nativosistemas/piezas3D/specs/009-espacio-conectores/checklists/requirements.md

# Lista de calidad de la especificación: Espacio para conectores y cableado

**Propósito**: validar que la especificación esté completa y sea de calidad antes de planificar
**Creada**: 2026-10-15
**Funcionalidad**: [spec.md](../spec.md)

## Calidad del contenido

- [x] Sin detalles de implementación (lenguajes, frameworks, APIs)
- [x] Centrada en el valor para el usuario y en las necesidades
- [x] Escrita para personas no técnicas
- [x] Todas las secciones obligatorias completas

## Completitud de los requisitos

- [x] No quedan marcadores [NEEDS CLARIFICATION]
- [x] Los requisitos se pueden probar y no son ambiguos
- [x] Los criterios de éxito son medibles
- [x] Los criterios de éxito no dependen de la tecnología
- [x] Todos los escenarios de aceptación están definidos
- [x] Los casos límite están identificados
- [x] El alcance está delimitado
- [x] Las dependencias y los supuestos están identificados

## Preparación de la funcionalidad

- [x] Todos los requisitos funcionales tienen criterios de aceptación claros
- [x] Los escenarios de usuario cubren los flujos principales
- [x] La funcionalidad cumple los resultados medibles de los criterios de éxito
- [x] No se filtran detalles de implementación en la especificación

## Notas

- Las menciones al ensamblaje, la tapa, la plataforma y los STL nombran artefactos del propio
  proyecto (como en 002 y 006), no tecnologías.
- El tipo de conector (rectos) se tomó como supuesto: es lo que figura en la lista de materiales y
  queda parametrizado.
