nativosistemas/piezas3D/specs/002-puntero-laser-estelar/checklists/requirements.md

# Lista de calidad de la especificación: Puntero láser estelar motorizado (alt-az)

**Propósito**: Validar que la especificación esté completa y sea de calidad antes de planificar
**Creada**: 2026-10-04
**Funcionalidad**: [spec.md](../spec.md)

## Calidad del contenido

- [x] Sin detalles de implementación (lenguajes, frameworks, APIs)
- [x] Centrada en el valor para el usuario y en sus necesidades
- [x] Redactada para personas sin conocimientos técnicos
- [x] Todas las secciones obligatorias completas

## Completitud de los requisitos

- [x] No quedan marcadores [NEEDS CLARIFICATION]
- [x] Los requisitos se pueden probar y no son ambiguos
- [x] Los criterios de éxito son medibles
- [x] Los criterios de éxito no dependen de la tecnología (sin detalles de implementación)
- [x] Todos los escenarios de aceptación están definidos
- [x] Los casos límite están identificados
- [x] El alcance está bien delimitado
- [x] Las dependencias y los supuestos están identificados

## Preparación de la funcionalidad

- [x] Todos los requisitos funcionales tienen criterios de aceptación claros
- [x] Los escenarios de usuario cubren los flujos principales
- [x] La funcionalidad cumple los resultados medibles de los criterios de éxito
- [x] No se filtran detalles de implementación en la especificación

## Notas

- Validación aprobada en la primera pasada.
- Los componentes comprados (28BYJ-48, ULN2003, ESP32, relé, láser 303, correa GT2, rodamientos
  608ZZ, rosca 3/8"-16) son **restricciones del usuario**, no decisiones de implementación. Por eso
  se nombran en la especificación. No se mencionan herramientas de software (OpenSCAD, FreeCAD) ni
  la forma de los archivos.
- Las medidas por defecto del láser, el power bank, el ESP32 y el relé son supuestos que hay que
  verificar midiendo los componentes reales antes de imprimir. Se pueden fijar en `/speckit-clarify`
  o en la planificación.
- El firmware del ESP32 queda fuera de alcance. Solo se documentan sus requisitos (FR-026).
