nativosistemas/piezas3D/specs/013-circuito-laser/checklists/requirements.md

# Lista de control de calidad de la especificación: Circuito del láser en el visor 3D

**Propósito**: Validar que la especificación esté completa y sea de calidad antes de planificar
**Creada**: 2026-10-19
**Funcionalidad**: [spec.md](../spec.md)

## Calidad del contenido

- [x] Sin detalles de implementación (lenguajes, bibliotecas, APIs)
- [x] Centrada en el valor para el usuario y en la necesidad
- [x] Escrita para personas no técnicas
- [x] Todas las secciones obligatorias completas

## Completitud de los requisitos

- [x] No quedan marcadores [NEEDS CLARIFICATION]
- [x] Los requisitos se pueden probar y no son ambiguos
- [x] Los criterios de éxito son medibles
- [x] Los criterios de éxito no dependen de la tecnología
- [x] Todos los escenarios de aceptación están definidos
- [x] Los casos límite están identificados
- [x] El alcance está bien delimitado
- [x] Las dependencias y los supuestos están identificados

## Preparación de la funcionalidad

- [x] Cada requisito funcional tiene criterios de aceptación claros
- [x] Los escenarios de usuario cubren los flujos principales
- [x] La funcionalidad cumple los resultados medibles de los criterios de éxito
- [x] No se filtran detalles de implementación en la especificación

## Notas

- La especificación nombra archivos del repositorio (ensamblaje, lista de materiales) y el paso 14
  porque son el objeto del pedido, como en las features 008 y 011; no fija cómo implementarlo.
- Decisiones tomadas sin preguntar (en Supuestos): el circuito empieza en la salida del regulador,
  las piezas metálicas se modelan simplificadas y el tubo del láser representa el retorno.
