nativosistemas/piezas3D/specs/012-marcas-orientacion/checklists/requirements.md

# Checklist de calidad de la especificación: Marcas de orientación y de altura del puntero láser

**Propósito**: validar que la especificación esté completa y sea de calidad antes de planificar
**Creada**: 2026-10-17
**Funcionalidad**: [spec.md](../spec.md)

## Calidad del contenido

- [x] Sin detalles de implementación (lenguajes, frameworks, APIs)
- [x] Centrada en el valor para el usuario y en sus necesidades
- [x] Redactada para personas no técnicas
- [x] Todas las secciones obligatorias completas

## Completitud de los requisitos

- [x] No quedan marcadores [NEEDS CLARIFICATION]
- [x] Los requisitos se pueden probar y no son ambiguos
- [x] Los criterios de éxito son medibles
- [x] Los criterios de éxito no dependen de la tecnología
- [x] Todos los escenarios de aceptación están definidos
- [x] Los casos límite están identificados
- [x] El alcance está bien delimitado
- [x] Las dependencias y los supuestos están identificados

## Preparación de la funcionalidad

- [x] Todos los requisitos funcionales tienen criterios de aceptación claros
- [x] Los escenarios de usuario cubren los flujos principales
- [x] La funcionalidad cumple los resultados medibles de los criterios de éxito
- [x] No se filtran detalles de implementación en la especificación

## Notas

- Las piezas se nombran (base fija, plataforma, polea de altura, brazo del motor) porque son el objeto
  del pedido, no un detalle de implementación. La forma, el tamaño y la ubicación exacta de cada marca
  quedan para el plan.
- El usuario descartó el nivel de burbuja y eligió la escala de altura cada 15°.
- El signo y el valor de la declinación magnética no se fijan en la spec: se verifican con una fuente
  oficial al escribir la guía.
