nativosistemas/piezas3D/specs/010-barra-distribucion/checklists/requirements.md

# Lista de control de calidad de la especificación: Barra de distribución de alimentación

**Propósito**: Validar que la especificación esté completa y sea de calidad antes de planificar
**Creada**: 2026-10-17
**Funcionalidad**: [spec.md](../spec.md)

## Calidad del contenido

- [x] Sin detalles de implementación (lenguajes, archivos, módulos)
- [x] Centrada en el valor para quien arma el aparato
- [x] Redactada para personas no especialistas en el código
- [x] Todas las secciones obligatorias completas

## Completitud de los requisitos

- [x] No quedan marcas [NEEDS CLARIFICATION]
- [x] Los requisitos se pueden probar y no son ambiguos
- [x] Los criterios de éxito son medibles
- [x] Los criterios de éxito no dependen de la tecnología
- [x] Todos los escenarios de aceptación están definidos
- [x] Los casos límite están identificados
- [x] El alcance está acotado
- [x] Las dependencias y los supuestos están identificados

## Preparación de la funcionalidad

- [x] Cada requisito funcional tiene criterios de aceptación claros
- [x] Los escenarios de usuario cubren los flujos principales
- [x] La funcionalidad cumple los resultados medibles de los criterios de éxito
- [x] No se filtran detalles de implementación en la especificación

## Notas

- Términos como Dupont, placa perforada, multímetro o comprobaciones de choque son del dominio
  (componentes y validación del diseño), no de la implementación; se usan igual que en la 009.
- Las medidas por defecto de la placa y la asignación de pines se confirman en `/speckit-plan`.
