nativosistemas/piezas3D/specs/004-caja-pilas-aa/checklists/requirements.md

# Lista de calidad de la especificación: Caja con tapa a presión para 4 pilas AA

**Propósito**: Validar que la especificación esté completa antes de planificar
**Creada**: 2026-10-06
**Funcionalidad**: [spec.md](../spec.md)

## Calidad del contenido

- [x] Sin detalles de implementación (lenguajes, frameworks, APIs)
- [x] Centrada en el valor para el usuario
- [x] Redactada para personas no técnicas
- [x] Todas las secciones obligatorias completas

## Completitud de los requisitos

- [x] No quedan marcadores [NEEDS CLARIFICATION]
- [x] Los requisitos se pueden probar y no son ambiguos
- [x] Los criterios de éxito son medibles
- [x] Los criterios de éxito no dependen de la tecnología
- [x] Todos los escenarios de aceptación están definidos
- [x] Los casos límite están identificados
- [x] El alcance está acotado
- [x] Dependencias y supuestos identificados

## Preparación de la funcionalidad

- [x] Todos los requisitos funcionales tienen criterios de aceptación claros
- [x] Los escenarios cubren los flujos principales
- [x] La funcionalidad cumple los resultados medibles de los criterios de éxito
- [x] No se filtran detalles de implementación en la especificación

## Notas

- Las herramientas (OpenSCAD, perfil de impresora) solo se nombran en los supuestos y en FR-009,
  porque las fija la constitución del proyecto, igual que en las especificaciones 001 y 002.
