nativosistemas/piezas3D/specs/005-visor-armado-3d/checklists/requirements.md

# Specification Quality Checklist: Visor 3D de armado paso a paso

**Purpose**: Validate specification completeness and quality before proceeding to planning
**Created**: 2026-10-08
**Feature**: [spec.md](../spec.md)

## Content Quality

- [x] No implementation details (languages, frameworks, APIs)
- [x] Focused on user value and business needs
- [x] Written for non-technical stakeholders
- [x] All mandatory sections completed

## Requirement Completeness

- [x] No [NEEDS CLARIFICATION] markers remain
- [x] Requirements are testable and unambiguous
- [x] Success criteria are measurable
- [x] Success criteria are technology-agnostic (no implementation details)
- [x] All acceptance scenarios are defined
- [x] Edge cases are identified
- [x] Scope is clearly bounded
- [x] Dependencies and assumptions identified

## Feature Readiness

- [x] All functional requirements have clear acceptance criteria
- [x] User scenarios cover primary flows
- [x] Feature meets measurable outcomes defined in Success Criteria
- [x] No implementation details leak into specification

## Notes

- Las 3 aclaraciones se resolvieron el 2026-10-08 (sección "Aclaraciones" de la especificación):
  visor en página aparte, realidad aumentada fuera del alcance y visor obligatorio (enmienda de la
  constitución).
- Las menciones a three.js, OpenSCAD y `generar_web.py` aparecen solo en la cita textual de la
  entrada del usuario; los requisitos no dependen de ellas.
