nativosistemas/piezas3D/specs/001-soporte-pared-taladro/checklists/requirements.md

# Lista de verificación de calidad de la especificación: Soporte de pared paramétrico para taladro

**Propósito**: Validar que la especificación está completa y tiene calidad suficiente antes de pasar a la planificación
**Creada**: 2026-10-04
**Funcionalidad**: [spec.md](../spec.md)

## Calidad del contenido

- [x] Sin detalles de implementación (lenguajes, frameworks, APIs)
- [x] Centrada en el valor para el usuario y en las necesidades del negocio
- [x] Redactada para personas no técnicas
- [x] Todas las secciones obligatorias completadas

## Completitud de los requisitos

- [x] No quedan marcadores [NEEDS CLARIFICATION]
- [x] Los requisitos son verificables y no ambiguos
- [x] Los criterios de éxito son medibles
- [x] Los criterios de éxito no dependen de la tecnología (sin detalles de implementación)
- [x] Todos los escenarios de aceptación están definidos
- [x] Los casos límite están identificados
- [x] El alcance está claramente delimitado
- [x] Las dependencias y los supuestos están identificados

## Preparación de la funcionalidad

- [x] Todos los requisitos funcionales tienen criterios de aceptación claros
- [x] Los escenarios de usuario cubren los flujos principales
- [x] La funcionalidad cumple los resultados medibles definidos en los criterios de éxito
- [x] No se filtran detalles de implementación en la especificación

## Notas

- Validación superada en la primera iteración (2026-10-04).
- La especificación no nombra herramientas de modelado ni de simulación; menciona conceptos de
  manufactura (FDM, perímetros, boquilla de 0,4 mm) porque forman parte del dominio del producto
  (una pieza impresa) y no de su implementación. Las herramientas las fija la constitución.
- No se usaron marcadores [NEEDS CLARIFICATION]: el tipo de taladro, el modo de sujeción (colgado
  por el portabrocas en ranura en U), la carga de diseño (2,5 kg, factor de seguridad 3) y el material
  (PETG) se resolvieron como supuestos documentados. Si alguno no coincide con la intención del
  usuario, conviene ajustarlo con `/speckit-clarify` antes de `/speckit-plan`.
- La validación estructural (FR-014/FR-015) se considera aplicable porque la pieza trabaja en
  voladizo bajo carga permanente (Principio III de la constitución).
