nativosistemas/piezas3D/specs/001-soporte-pared-taladro/spec.md

# Especificación de Funcionalidad: Soporte de pared paramétrico para taladro

**Rama de la funcionalidad**: N/A (sin hook de creación de rama; se trabaja sobre `main`)

**Creada**: 2026-10-04

**Estado**: Implementada (pendiente de la prueba física)

**Entrada**: Descripción del usuario: "Soporte de pared paramétrico para un taladro, con ancho, profundidad y diámetro de tornillos ajustables"

## Escenarios de usuario y pruebas *(obligatorio)*

### Historia de usuario 1 - Fabricar e instalar el soporte con valores por defecto (Prioridad: P1)

Una persona aficionada al bricolaje quiere guardar su taladro atornillador inalámbrico colgado en la
pared del taller. Toma el diseño con sus valores por defecto, imprime la pieza en una impresora 3D
doméstica de filamento, la atornilla a la pared siguiendo la guía de producción y cuelga el taladro
con la punta (portabrocas) hacia abajo, pasando el portabrocas por la ranura frontal del soporte de
modo que el cuerpo del taladro descanse sobre la bandeja.

**Por qué esta prioridad**: es el valor central de la funcionalidad: una pieza física, lista para
imprimir y montar, que sostiene un taladro estándar de forma segura sin que el usuario tenga que
modificar nada.

**Prueba independiente**: se imprime la pieza por defecto, se fija a una pared con la tornillería
indicada en la guía y se cuelga un taladro inalámbrico típico con batería; el taladro queda estable,
se puede sacar y volver a colocar con una mano y la pieza no presenta grietas ni deformación visible.

**Escenarios de aceptación**:

1. **Dado** el diseño con sus valores por defecto, **cuando** se prepara para imprimir, **entonces**
   la pieza se imprime en una sola pieza, sin material de soporte, en una cama de impresión de
   180 × 180 mm o mayor.
2. **Dado** el soporte impreso y fijado a la pared con 2 tornillos del diámetro por defecto,
   **cuando** se cuelga un taladro inalámbrico de hasta 2,5 kg (con batería), **entonces** el taladro
   queda retenido por el portabrocas en la ranura, sin caerse ni balancearse hasta salirse.
3. **Dado** el taladro colgado, **cuando** el usuario lo retira y lo vuelve a colocar con una sola
   mano, **entonces** la operación no requiere forzar la pieza ni herramientas.
4. **Dado** el diseño entregado, **cuando** el usuario consulta la guía de producción, **entonces**
   encuentra la orientación de impresión, los parámetros del laminador, el material recomendado, la
   lista de tornillería y los pasos de instalación en pared.

---

### Historia de usuario 2 - Adaptar el soporte a un taladro y una tornillería concretos (Prioridad: P2)

El usuario tiene un taladro más grande (o más pequeño) que el de referencia, o dispone de tornillos de
otro diámetro. Ajusta los parámetros de ancho, profundidad y diámetro de tornillo (y, si lo necesita,
el ancho de la ranura del portabrocas) en la sección de parámetros del diseño y obtiene una nueva pieza
coherente con esos valores, sin tener que modificar la geometría.

**Por qué esta prioridad**: la parametrización es lo que convierte la pieza en un generador
reutilizable; sin ella solo serviría para un taladro concreto.

**Prueba independiente**: se cambian el ancho, la profundidad y el diámetro de tornillo a valores
dentro de los rangos admitidos, se regenera la pieza y se miden en el modelo resultante las cotas
afectadas; coinciden con los valores introducidos (dentro de la tolerancia declarada).

**Escenarios de aceptación**:

1. **Dado** el diseño, **cuando** el usuario cambia el ancho a 100 mm, **entonces** la pieza generada
   mide 100 mm de ancho y la ranura sigue centrada.
2. **Dado** el diseño, **cuando** el usuario cambia la profundidad a 130 mm, **entonces** la bandeja
   sobresale 130 mm de la pared y los refuerzos laterales se escalan en proporción.
3. **Dado** el diseño, **cuando** el usuario cambia el diámetro de tornillo de 5 mm a 4 mm,
   **entonces** los orificios de fijación y sus avellanados se recalculan para ese tornillo, con la
   holgura de paso declarada.
4. **Dado** el diseño, **cuando** el usuario introduce una combinación imposible (p. ej., una ranura
   más ancha que el ancho disponible), **entonces** la generación se detiene con un mensaje que indica
   qué parámetro está fuera de rango y cuál es el límite.

---
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
