nativosistemas/piezas3D/specs/012-marcas-orientacion/tasks.md

---

description: "Lista de tareas de las marcas de orientación y de altura del puntero láser"
---

# Tareas: Marcas de orientación y de altura del puntero láser

**Entrada**: documentos de diseño de `specs/012-marcas-orientacion/`

**Requisitos previos**: [plan.md](plan.md), [spec.md](spec.md), [research.md](research.md),
[data-model.md](data-model.md), [contracts/](contracts/), [quickstart.md](quickstart.md)

**Pruebas**: no hay tareas de prueba aparte. Cada fase se cierra con las validaciones de OpenSCAD
(M-01 a M-09), los casos que fallan a propósito, las capturas y los escenarios del quickstart.

**Organización**: por las cinco fases del pipeline (Principio II, como en la 009 a la 011). Cada tarea
lleva su historia de usuario:
- **US1**: orientar el aparato al sur y al oeste (P1).
- **US2**: reconocer el láser horizontal y leer su altura (P1).
- **US3**: arrancar desde una posición conocida (P2).
- **US4**: ver las marcas en la web y en el visor 3D (P3).
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
