nativosistemas/piezas3D/docs/img/caja_pilas_paso_01.png

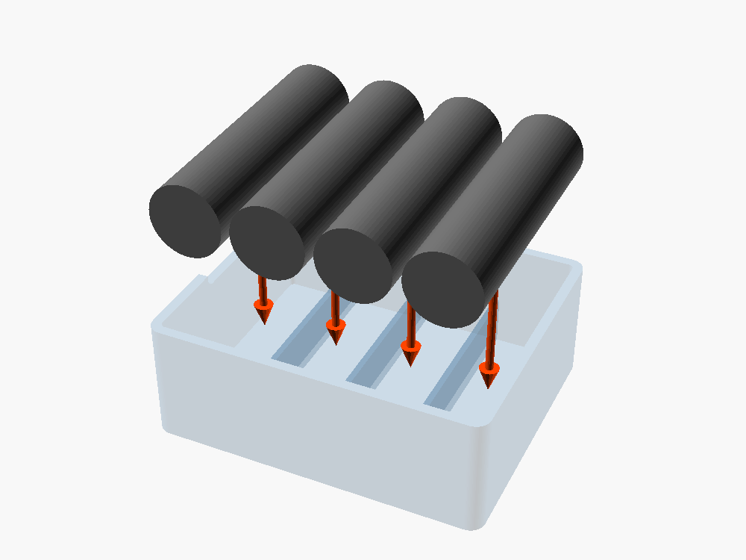
docs/img/caja_pilas_paso_01.png
