nativosistemas/piezas3D/docs/img/caja_pilas_paso_02.png

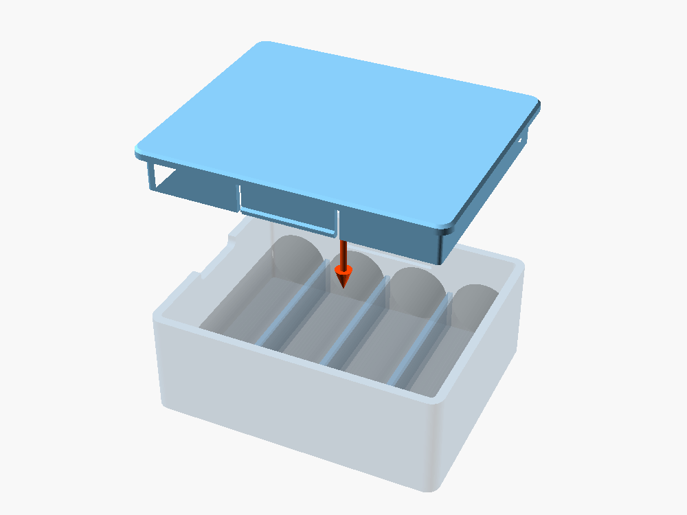
docs/img/caja_pilas_paso_02.png
