nativosistemas/piezas3D/docs/img/puntero_laser_paso_02.png

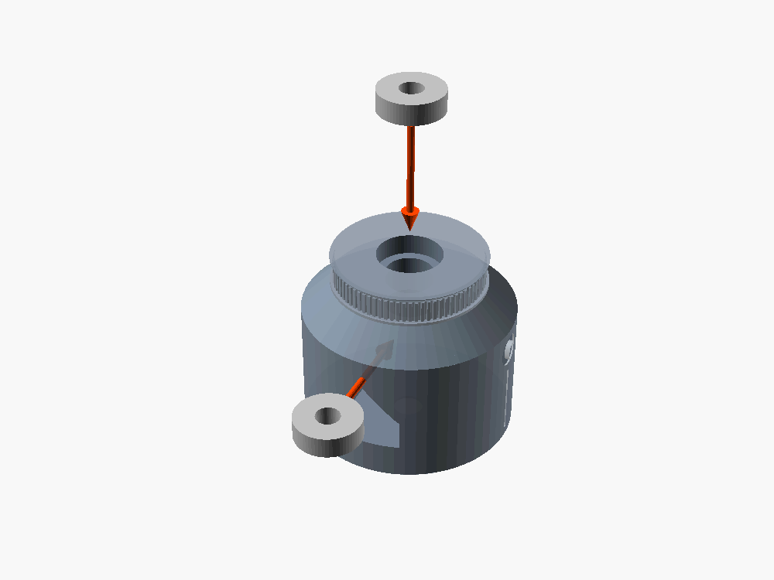
docs/img/puntero_laser_paso_02.png
