nativosistemas/piezas3D/docs/img/puntero_laser_paso_03.png

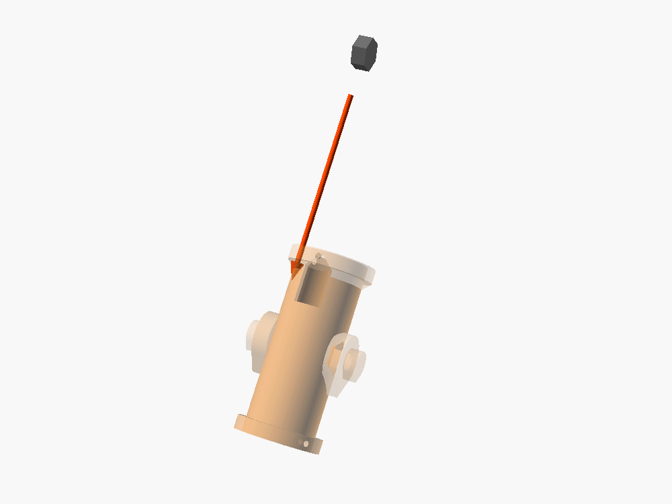
docs/img/puntero_laser_paso_03.png
