nativosistemas/piezas3D/docs/img/puntero_laser_paso_04.png

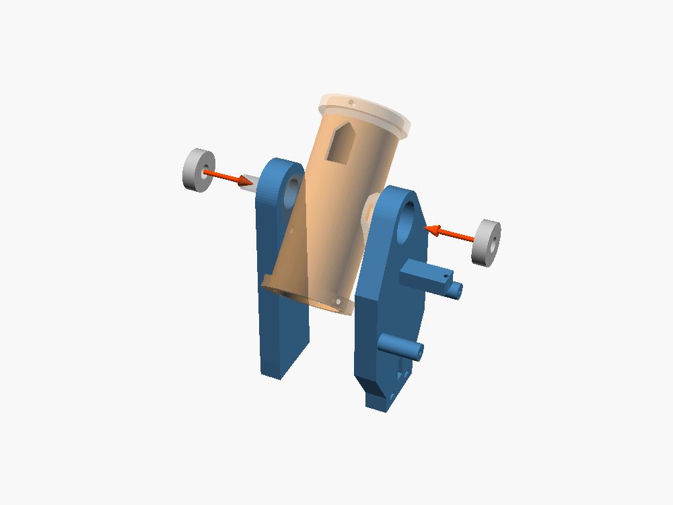
docs/img/puntero_laser_paso_04.png
