nativosistemas/piezas3D/docs/img/puntero_laser_paso_05.png

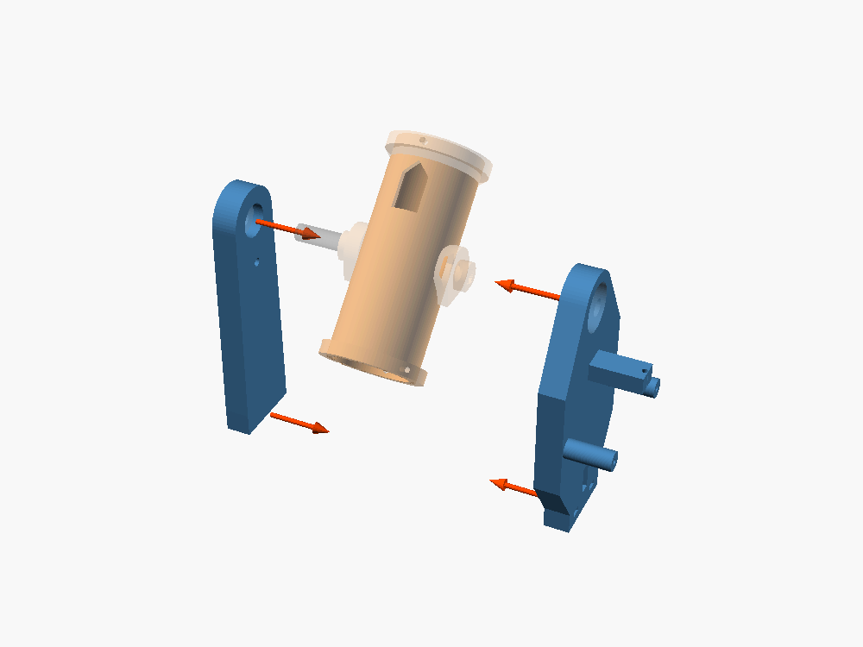
docs/img/puntero_laser_paso_05.png
