nativosistemas/piezas3D/docs/img/puntero_laser_paso_06.png

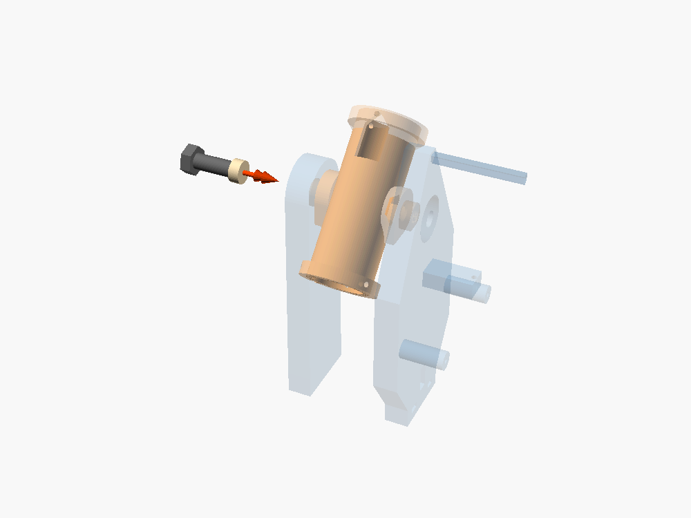
docs/img/puntero_laser_paso_06.png
