nativosistemas/piezas3D/docs/img/puntero_laser_paso_07.png

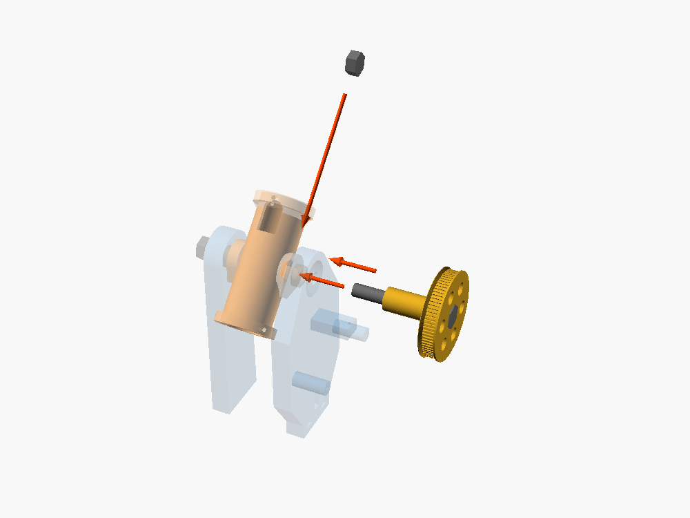
docs/img/puntero_laser_paso_07.png
