nativosistemas/piezas3D/docs/img/puntero_laser_paso_08.png

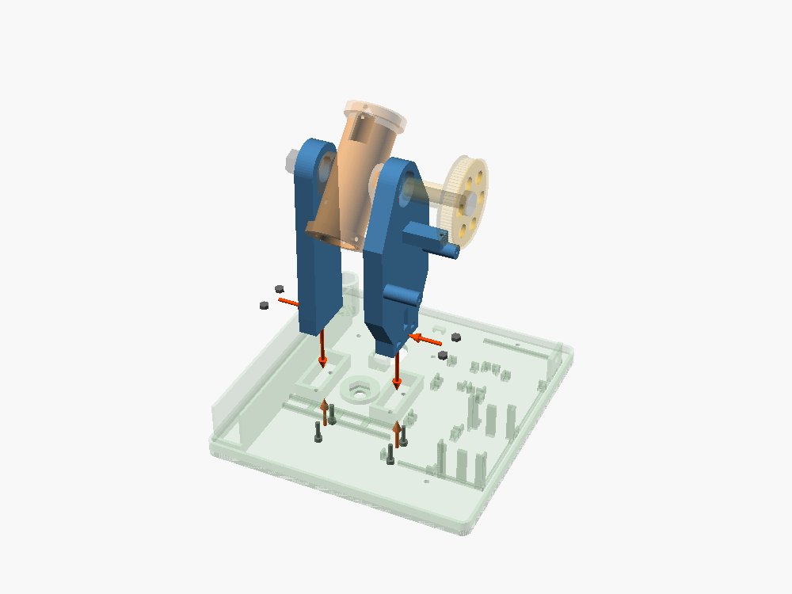
docs/img/puntero_laser_paso_08.png
