nativosistemas/piezas3D/docs/img/puntero_laser_paso_10.png

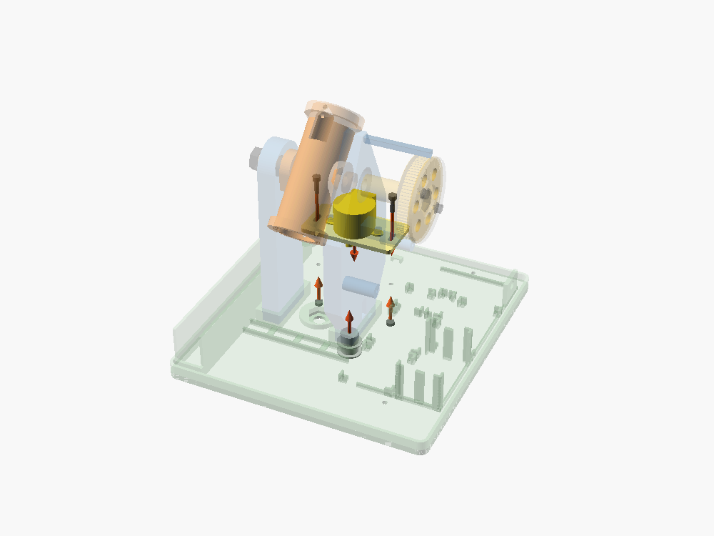
docs/img/puntero_laser_paso_10.png
