nativosistemas/piezas3D/docs/img/puntero_laser_paso_11.png

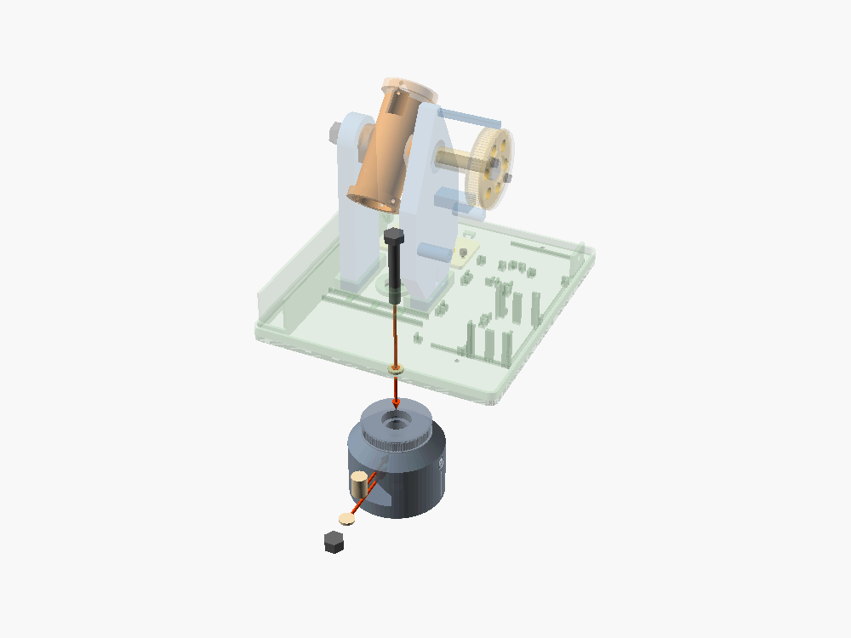
docs/img/puntero_laser_paso_11.png
