nativosistemas/piezas3D/docs/img/puntero_laser_paso_13.png

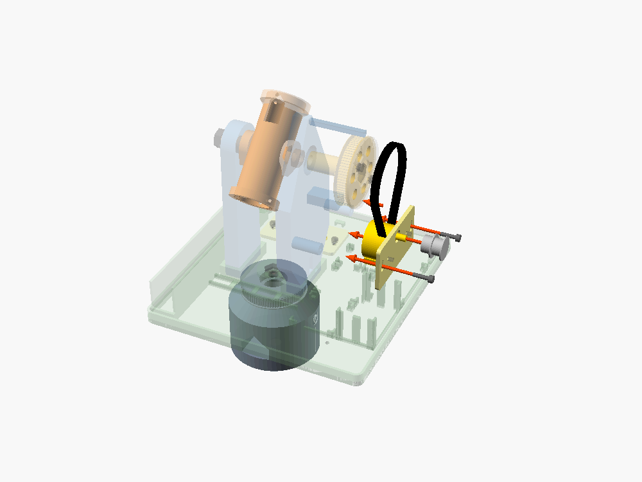
docs/img/puntero_laser_paso_13.png
