nativosistemas/piezas3D/docs/img/puntero_laser_paso_15.png

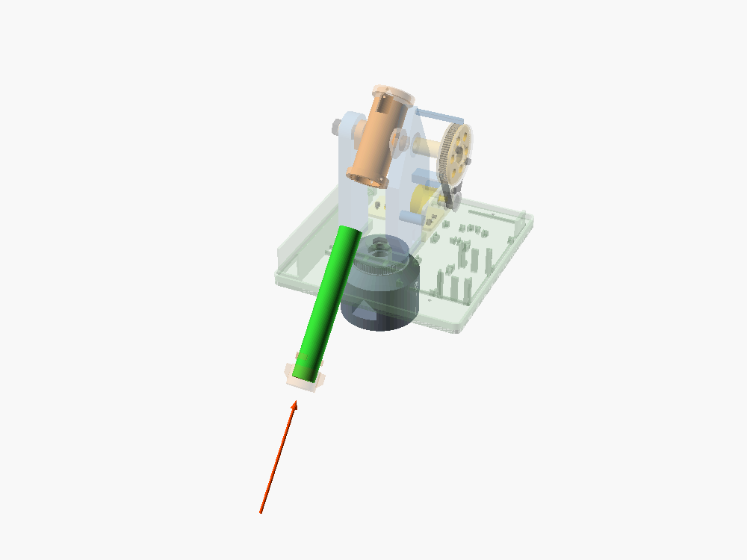
docs/img/puntero_laser_paso_15.png
