nativosistemas/piezas3D/docs/img/puntero_laser_paso_16.png

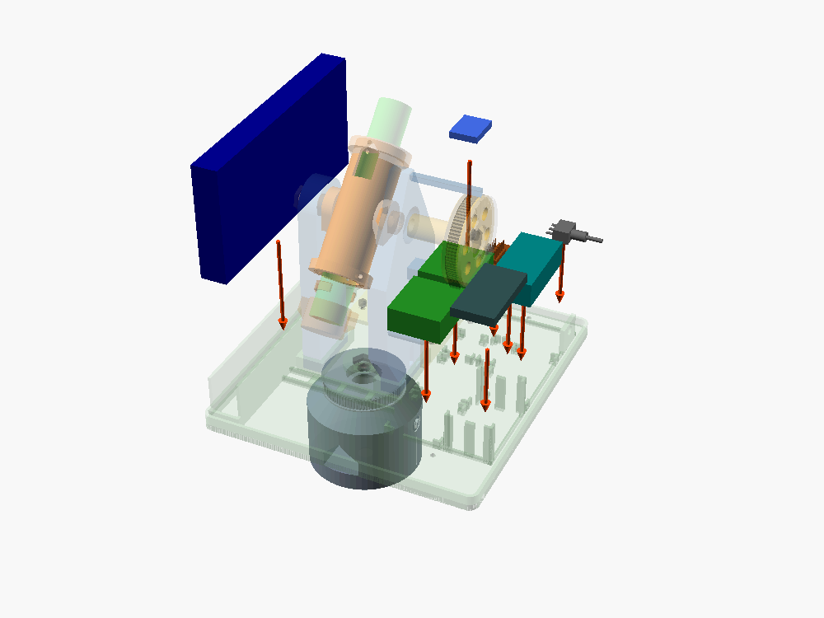
docs/img/puntero_laser_paso_16.png
