nativosistemas/piezas3D/docs/img/puntero_laser_paso_17.png

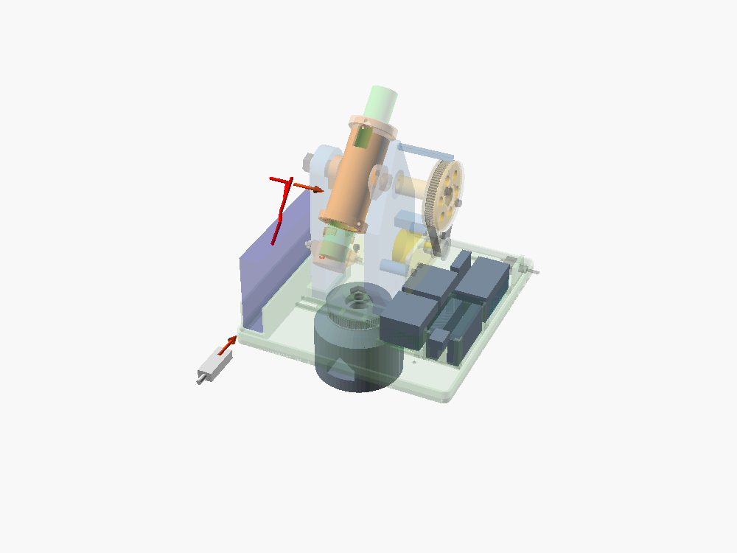
docs/img/puntero_laser_paso_17.png
