nativosistemas/piezas3D/docs/caja_pilas_bom.csv

categoria | texto_cantidad | descripcion | cantidad | unidad | paquete | opcional | en_guia | tengo | precio | moneda | tienda | url | fecha | nota
Filamento | 40 g de | filamento PETG de 1,75 mm (caja ≈ 25 g y tapa ≈ 12 g) | 40 | g | 1000 | no | si |  | 21100 | ARS | Printalot | https://printalot.com.ar/productos/filamentos/pet-g/petg-1-75-mm-1-kg/ | 2026-10-06 | Rollo de 1 kg. La página no confirma el stock. 40 g es la estimación por volumen de los STL: el laminador da el valor exacto
