nativosistemas/piezas3D/docs/tipo_cambio.csv

fecha | moneda | valor_ars | tipo | fuente | url
2026-10-05 | USD | 1540 | Dólar oficial (venta) | DolarApi | https://dolarapi.com/v1/dolares/oficial
