nativosistemas/piezas3D/exports/puntero_laser_disco_escala.stl

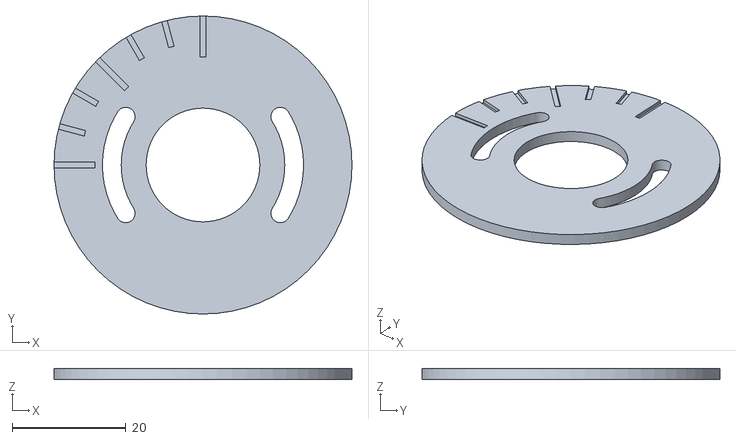
[picture p31: CAD file, 2026-10-17]
exports/puntero_laser_disco_escala.stl
52.4 x 52.4 x 2.00
