nativosistemas/piezas3D/simulation/soporte_pared_taladro.FCStd

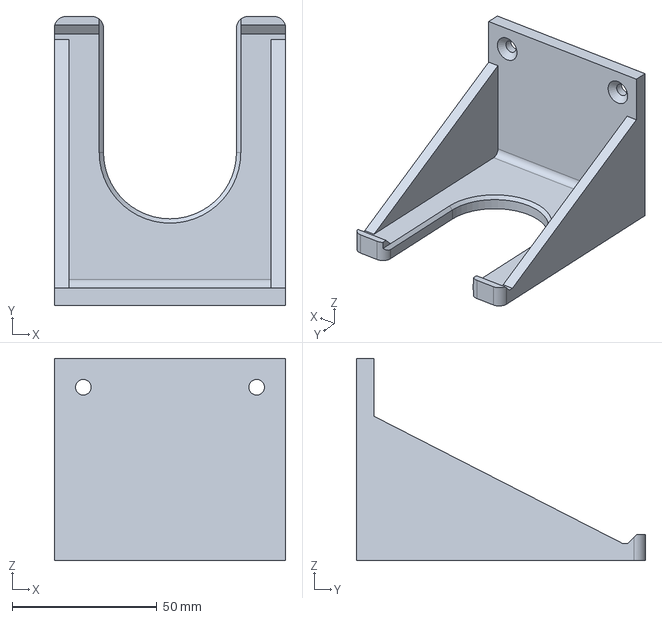
[picture p32: CAD file, 2026-10-04]
simulation/soporte_pared_taladro.FCStd
80.0 x 100.0 x 70.0 mm
