nativosistemas/piezas3D/exports/puntero_laser_adaptador_tripode.stl

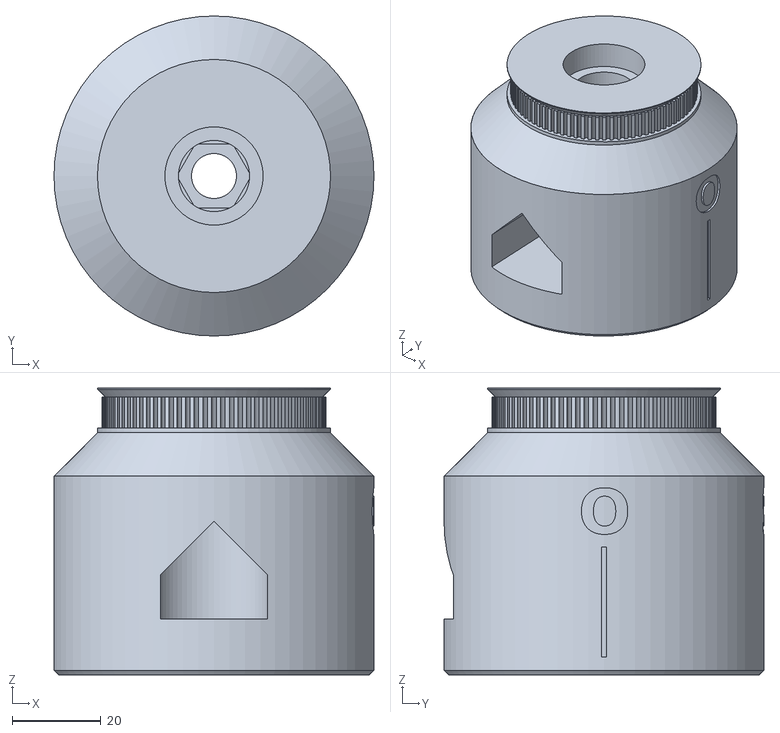
[picture p33: CAD file, 2026-10-17]
exports/puntero_laser_adaptador_tripode.stl
72.0 x 72.0 x 64.5
