nativosistemas/piezas3D/exports/puntero_laser_brazo_horquilla_motor.stl

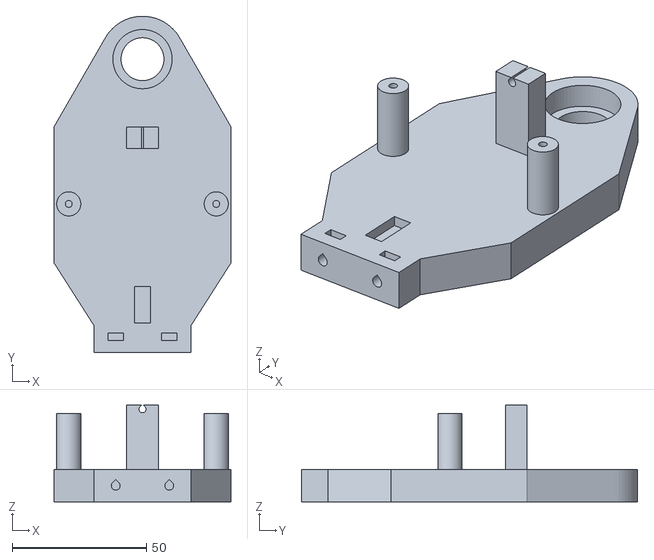
[picture p34: CAD file, 2026-10-17]
exports/puntero_laser_brazo_horquilla_motor.stl
66.0 x 125.5 x 36.0
