nativosistemas/piezas3D/exports/puntero_laser_grapa_cable.stl

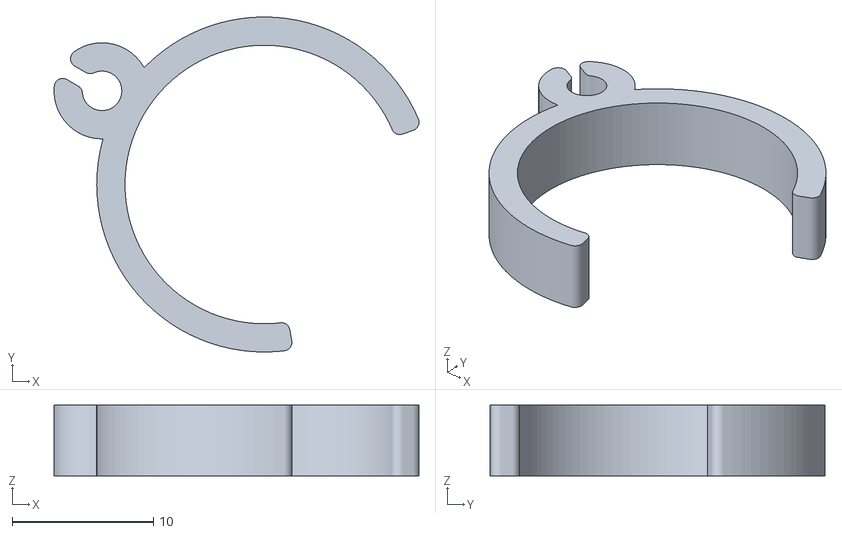
[picture p35: CAD file, 2026-10-17]
exports/puntero_laser_grapa_cable.stl
25.8 x 23.7 x 5.00
