nativosistemas/piezas3D/exports/puntero_laser_carro_motor.stl

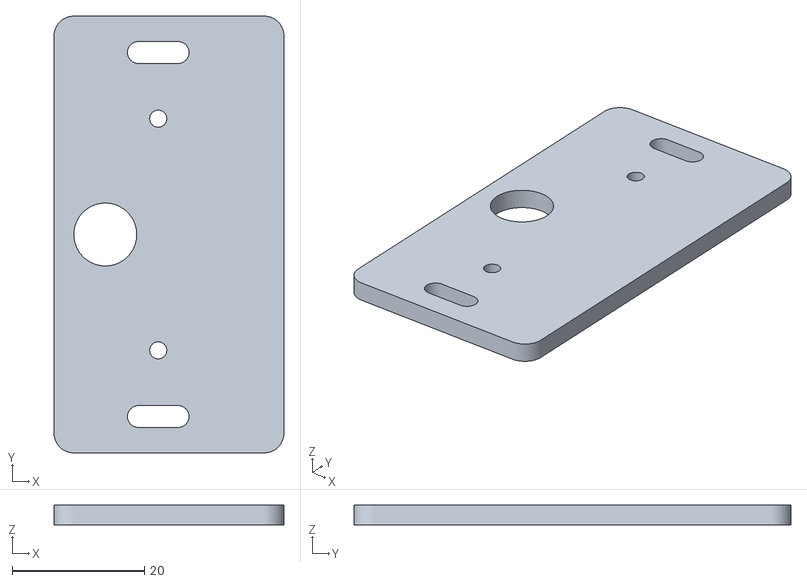
[picture p36: CAD file, 2026-10-17]
exports/puntero_laser_carro_motor.stl
34.8 x 66.0 x 3.00
