nativosistemas/piezas3D/exports/puntero_laser_pila_falsa.stl

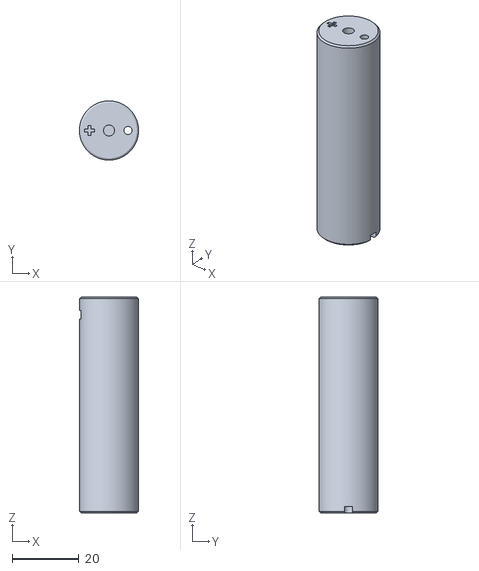
[picture p37: CAD file, 2026-10-15]
exports/puntero_laser_pila_falsa.stl
17.7 x 17.7 x 64.5
