nativosistemas/piezas3D/exports/puntero_laser_cuna_laser.stl

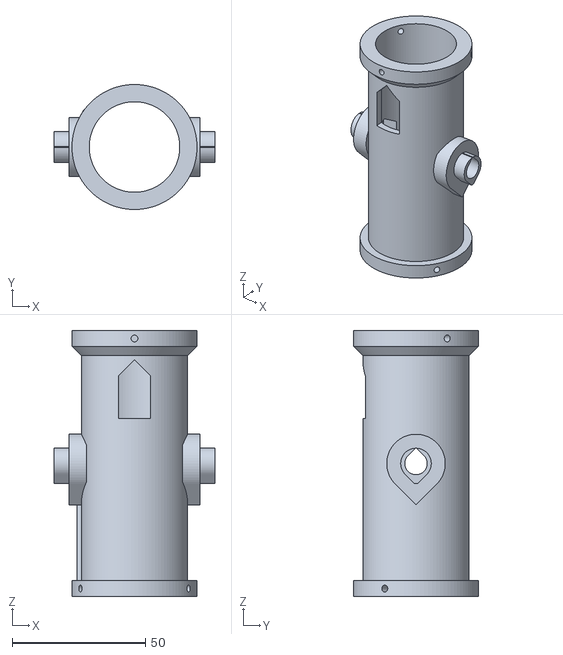
[picture p38: CAD file, 2026-10-15]
exports/puntero_laser_cuna_laser.stl
60.4 x 47.0 x 100.0
