nativosistemas/piezas3D/exports/puntero_laser_brazo_horquilla_cable.stl

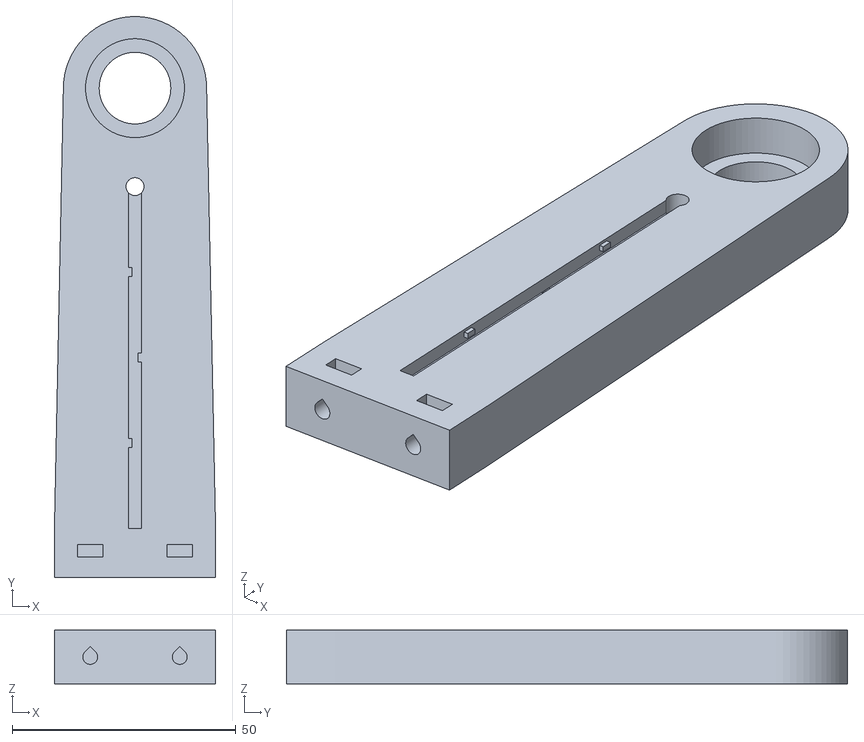
[picture p39: CAD file, 2026-10-15]
exports/puntero_laser_brazo_horquilla_cable.stl
36.0 x 125.3 x 12.0
