nativosistemas/piezas3D/exports/puntero_laser_tapa_electronica.stl

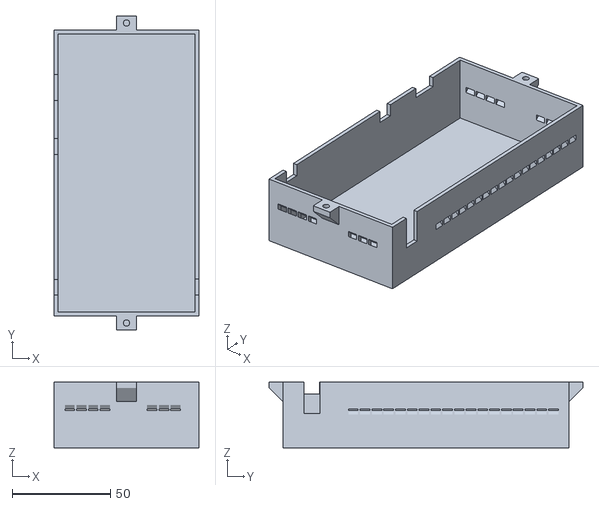
[picture p40: CAD file, 2026-10-15]
exports/puntero_laser_tapa_electronica.stl
73.9 x 159.9 x 33.5
