nativosistemas/piezas3D/exports/caja_pilas_tapa.stl

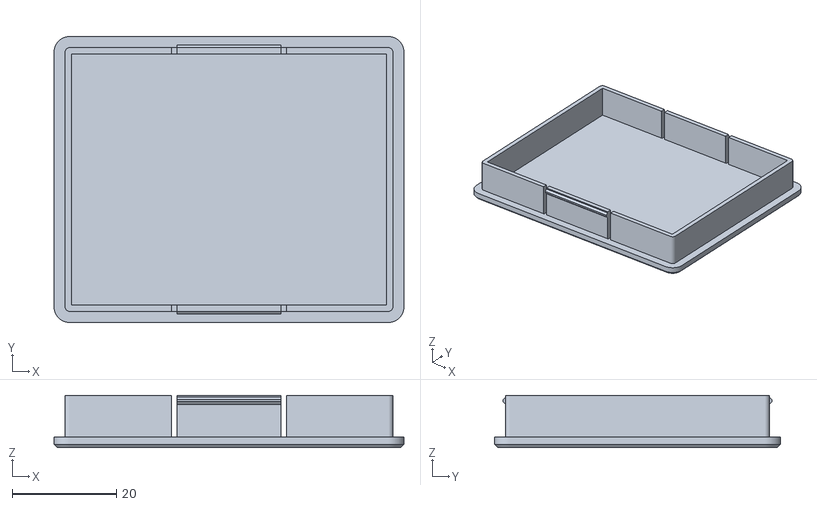
[picture p41: CAD file, 2026-10-08]
exports/caja_pilas_tapa.stl
67.2 x 54.9 x 10.0
