nativosistemas/piezas3D/exports/caja_pilas_caja.stl

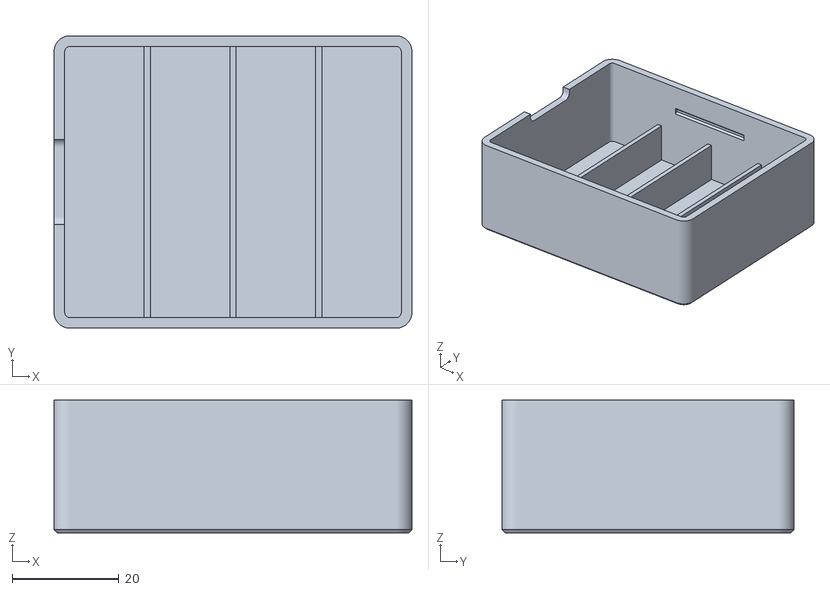
[picture p42: CAD file, 2026-10-08]
exports/caja_pilas_caja.stl
67.2 x 54.9 x 24.9
