nativosistemas/piezas3D/exports/puntero_laser_polea_altitud.stl

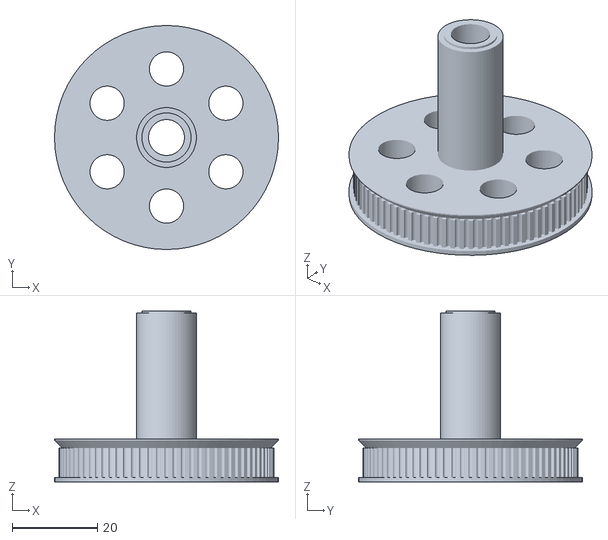
[picture p43: CAD file, 2026-10-08]
exports/puntero_laser_polea_altitud.stl
52.4 x 52.4 x 40.0
