nativosistemas/piezas3D/exports/puntero_laser_probeta_ajuste_608.stl

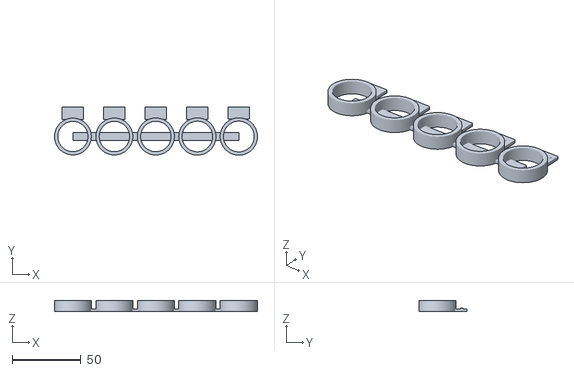
[picture p44: CAD file, 2026-10-05]
exports/puntero_laser_probeta_ajuste_608.stl
147.3 x 35.1 x 8.00
