nativosistemas/piezas3D/exports/puntero_laser_plataforma_azimut.stl

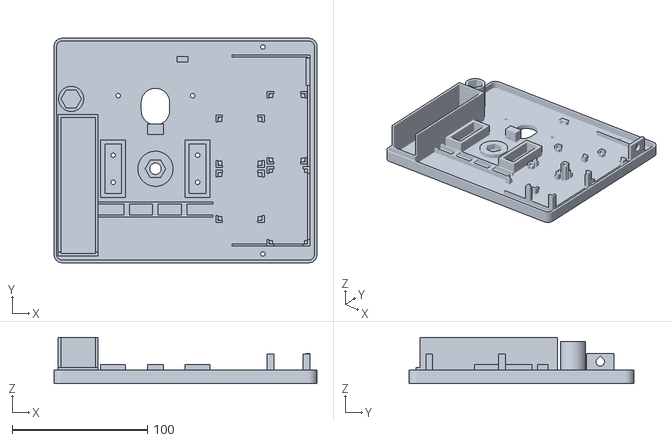
[picture p45: CAD file, 2026-10-05]
exports/puntero_laser_plataforma_azimut.stl
194.3 x 165.9 x 34.0
