nativosistemas/piezas3D/exports/puntero_laser_separador_azimut.stl

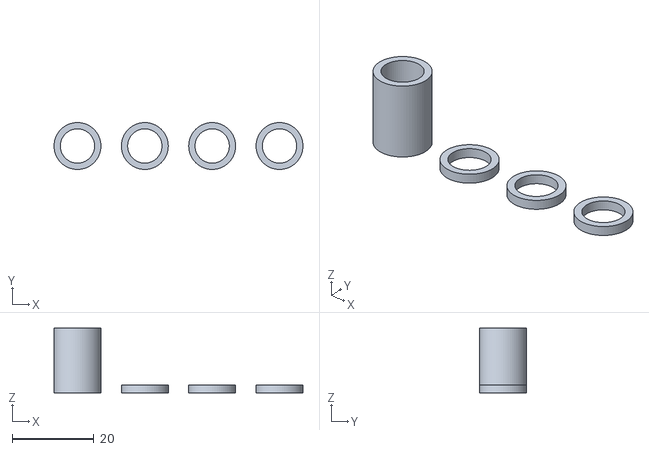
[picture p46: CAD file, 2026-10-05]
exports/puntero_laser_separador_azimut.stl
61.0 x 11.5 x 15.9
