nativosistemas/piezas3D/src/puntero_laser_parametros.scad

// ==========================================
// Proyecto: piezas3D – Puntero láser estelar
// Componente: Parámetros compartidos
// Descripción: Medidas compartidas por todas las piezas del puntero láser motorizado alt-az:
//              parámetros editables, constantes de componentes estándar, valores derivados,
//              reglas de validación (V-01…V-25, V-27…V-30) y módulos utilitarios (dentado GT2, etc.).
//              Desde la 006, el láser va sin batería: lo alimenta el power bank a través de una pila
//              falsa y una tapa trasera impresa con lastre.
//              No dibuja nada; al renderizarlo solo imprime los derivados con echo.
// ==========================================
//
// Convención de ejes del conjunto (research.md):
//   Origen en la cara de apoyo de la base sobre el trípode. Z vertical = eje de azimut.
//   Eje de altura paralelo a X, a la altura z_eje_altura. A 0° de altura el láser apunta a +Y.
//   Lado +X: motor de altura y placas electrónicas (bajo la tapa). Lado −X: power bank.
//   Motor de azimut en +Y (franja que el extremo trasero del láser no barre).

// --- PARÁMETROS Y CONSTANTES ---

/* [Componentes comprados] */
// Diámetro del cuerpo del láser 303 (medir el ejemplar real)
diametro_laser = 20; // [20:0.5:40]
// Largo total del láser con su tapa original (medir el ejemplar real)
largo_laser = 152; // [120:1:260]
// Distancia del extremo trasero del láser a su punto de equilibrio, con batería y tapa original (medir apoyándolo sobre un borde)
distancia_trasera_centro_masa = 76; // [48:1:156]
// Masa del láser con su batería y su tapa original, en gramos (solo para los cálculos)
masa_laser_g = 130; // [80:5:400]
// Largo del power bank (medir el ejemplar real)
powerbank_largo = 147; // [60:1:150]
// Ancho del power bank; queda vertical porque el power bank va de pie (medir)
powerbank_ancho = 71; // [40:1:75]
// Espesor del power bank (medir)
powerbank_alto = 16; // [10:1:30]
// Largo de la placa ESP32 DevKit (medir)
esp32_largo = 48; // [48:0.5:60]
// Ancho de la placa ESP32 DevKit (medir)
esp32_ancho = 25.5; // [25:0.5:32]
// Largo del módulo relé (medir)
rele_largo = 50; // [35:0.5:55]
// Ancho del módulo relé (medir)
rele_ancho = 26; // [17:0.5:30]
// Largo de la placa ULN2003 (medir)
uln2003_largo = 35; // [30:0.5:42]
// Ancho de la placa ULN2003 (medir)
uln2003_ancho = 32; // [20:0.5:35]
// Altura máxima de una placa con sus componentes (relé y ULN2003)
altura_placas = 18; // [10:1:25]

/* [Láser sin batería] */
// Diámetro interior del tubo donde iba la batería (medir)
diametro_hueco_bateria = 18.5; // [16:0.1:22]
// Del borde trasero del tubo al contacto del cabezal, con el resorte libre (medir con la varilla del calibre)
profundidad_hueco_bateria = 65; // [34:0.5:70]
// Diámetro exterior de la rosca donde enroscaba la tapa original (medir)
diametro_zona_tapa = 20; // [20:0.1:40]
// Largo de esa rosca (medir)
largo_zona_tapa = 10; // [8:0.5:20]
// Cuánto sobresale la tapa original del borde del tubo (medir)
largo_tapa_original = 20; // [5:0.5:40]
// Masa de la batería que se quita, en gramos
masa_bateria_g = 45; // [15:1:60]
// Masa de la tapa original que se quita, en gramos
masa_tapa_original_g = 10; // [5:1:40]
// Tuercas M10 de lastre en la tapa impresa (devuelven el centro de masa hacia atrás)
tuercas_lastre_tapa = 0; // [0:1:3]
// 0 = se calcula; si no, punto de equilibrio medido desde el extremo trasero de la tapa impresa
distancia_trasera_centro_masa_nueva = 0; // [0:1:200]
// Largo del módulo reductor de tensión (MP1584EN: 22 mm)
regulador_largo = 22; // [15:0.5:25]
// Ancho del módulo reductor de tensión (MP1584EN: 17 mm)
regulador_ancho = 17; // [10:0.5:18]

/* [Conectores y cables] */
// Largo del cuerpo plástico de un Dupont hembra recto (medir)
largo_dupont = 14; // [10:0.5:20]
// Alto del plástico de las tiras de pines macho de las placas (medir)
alto_tira_pines = 2.5; // [2:0.1:3.5]
// Diámetro del cable de un Dupont
diametro_cable_dupont = 1.4; // [1:0.1:2]
// Radio mínimo de curva del cable al salir del conector, medido al eje del cable
radio_curva_cable = 5; // [3:0.5:10]
// Alto del enchufe del motor ya conectado en su ULN2003, sobre la placa (medir)
alto_enchufe_motor = 13; // [9:0.5:18]
// Pines de cada fila del ESP32 (15 en el de 30 pines, 19 en el de 38)
pines_por_lado_esp32 = 19; // [15:1:20]
// Ancho de la funda del enchufe USB del cable para cargar el firmware (medir)
ancho_enchufe_usb = 11; // [8:0.5:14]
// Alto de la funda del enchufe USB (medir)
alto_enchufe_usb = 7.5; // [5:0.5:10]
// Largo del cable de fábrica del motor 28BYJ-48, del motor al enchufe (medir)
largo_cable_motor = 230; // [150:5:400]
// Pines de cada tira de la barra de distribución (+5 V y GND): destinos + reserva (010)
pines_barra = 6; // [6:1:10]
// Largo del trozo de placa perforada de la barra (medir; 3 × 10 agujeros = 25,4 mm)
barra_largo = 25.4; // [20:0.1:36]
// Ancho del trozo de placa perforada de la barra (medir)
barra_ancho = 7.6; // [7:0.1:10]

/* [Transmisión] */
// Dientes de la polea conducida impresa (≥ 80 para la relación ≥ 1:4 de FR-005)
dientes_polea_conducida = 80; // [80:1:100]
// Largo de la correa GT2 cerrada comercial, en mm
largo_correa = 200; // [160:2:240]
// Ancho de la correa GT2
ancho_correa = 6; // [6:1:9]
// Recorrido del tensor a cada lado de la posición nominal
recorrido_tensor = 3; // [2:0.5:6]
// Corrección del radio del hueco del diente GT2 impreso (ajuste de la impresora)
ajuste_diente_gt2 = 0; // [-0.15:0.01:0.15]

/* [Holguras] */
// Holgura de encastre entre piezas y de los soportes de placas
holgura_encastre = 0.25; // [0.1:0.05:0.5]
// Holgura de paso de los tornillos M3
holgura_tornillo_m3 = 0.3; // [0.1:0.05:0.6]
// Holgura entre caras de los alojamientos de tuercas y cabezas hexagonales
holgura_tuerca = 0.2; // [0.1:0.05:0.4]
// Holgura de paso de los pernos M8
holgura_perno_m8 = 0.4; // [0.2:0.05:0.8]
// Ajuste a presión de los 608ZZ (se suma a 22 mm; calibrar con la probeta)
ajuste_608 = 0.10; // [-0.1:0.01:0.3]
// Holgura mínima entre el láser y lo que hay debajo al apuntar al cenit
holgura_barrido = 8; // [5:1:20]

/* [Estructura] */
// Espesor de la placa de la plataforma de azimut
espesor_plataforma = 4; // [3:0.5:6]
// Espesor de los brazos de la horquilla (≥ ancho del 608 + labio)
espesor_brazo = 12; // [10:0.5:14]
// Ancho de los brazos de la horquilla
ancho_brazo = 36; // [30:1:45]
// Pared del tubo de la cuna del láser
pared_tubo_cuna = 3; // [2:0.5:4]
// Largo del tubo de la cuna del láser
largo_tubo_cuna = 80; // [70:1:140]
// Holgura radial entre el láser y la cuna (rango de colimación por lado)
holgura_colimacion = 2; // [1:0.25:3]
// Alto del resalte que separa los dos 608 de azimut
separacion_608_azimut = 16; // [10:1:30]
// Diámetro de la cara de apoyo de la base sobre el trípode
diametro_apoyo_tripode = 72; // [60:1:90]
// Alojamiento para contrapeso (tuercas M8) en la plataforma
con_contrapeso = true;
// Ventana en la cuna para llegar al pulsador del láser
con_ventana_pulsador = true;

/* [Marcas] */
// Profundidad de los grabados (letras, índices y escala)
profundidad_grabado = 0.6; // [0.4:0.1:1]
// Ancho de las rayas de la escala de altura
ancho_raya = 1.0; // [0.8:0.1:1.5]
// Ancho de las líneas de referencia (bajo las letras e índice de azimut)
ancho_linea_referencia = 1.2; // [0.8:0.1:2]
// Alto de las letras «S» y «O» de la base
alto_letra = 10; // [6:1:14]
// Tipografía de las letras
fuente_marcas = "Liberation Sans:style=Bold";
// Espesor del disco de la escala de altura
espesor_disco_escala = 2; // [1.6:0.2:3]
// Agujero central del disco (deja pasar la llave tubo de 13 mm del perno M8)
d_interior_disco_escala = 20; // [18:0.5:24]
// Giro de las ranuras del disco a cada lado (≥ 30° para cubrir el escalón de 60° del hexágono)
giro_ranura_disco = 32; // [20:1:40]
// Ángulo entre rayas de la escala
paso_escala = 15; // [5:5:30]
// Última raya de la escala
angulo_escala_max = 90; // [45:5:95]
// Holgura radial entre la pestaña de la polea de altura y la aguja de índice
holgura_aguja = 2.5; // [0.5:0.5:6]
// Sección de la aguja de índice: [radial, tangencial]
seccion_aguja = [5, 4];

/* [Calidad] */
// Resolución de los círculos
$fn = 64; // [24:8:128]

/* [Hidden] */
// ---------- Perfil de impresora (holguras de encaje y límites; constitución, Principio IV) ----------
include <perfil_impresora.scad>
// ---------- Constantes de componentes estándar (Entidad 2 de data-model.md) ----------
// Rodamiento 608ZZ
rod608_d_ext = 22;
rod608_d_int = 8;
rod608_ancho = 7;
rod608_d_aro_int = 12.1;
// Perno y tuerca M8
m8_cabeza_ec = 13;
m8_cabeza_alto = 5.3;
m8_tuerca_ec = 13;
m8_autoblocante_alto = 8;
m8_tuerca_alto = 6.5;          // tuerca común DIN 934 (la del muñón del lado motor)
// M3
m3_d = 3;
m3_tuerca_ec = 5.5;
m3_tuerca_alto = 2.4;
m3_cabeza_d = 5.5;
d_arandela_m3 = 7;           // arandela M3 (DIN 125)
alto_arandela_m3 = 0.5;
diametro_autorroscante_m3 = 2.6;   // 85 % de M3
// Tuerca 3/8"-16 UNC del trípode
tuerca_3_8_ec = 14.29;
tuerca_3_8_alto = 8.33;
rosca_3_8_d = 9.525;
// Motor 28BYJ-48 (sistema propio: eje en el origen, cuerpo desplazado hacia +X)
motor_d_cuerpo = 28;
motor_alto_cuerpo = 19;
motor_entre_orejas = 35;
motor_d_agujero_oreja = 4.2;
motor_d_oreja = 7;
motor_desplazamiento_eje = 8;
motor_d_resalte = 9;
motor_alto_resalte = 1.5;
motor_largo_eje = 9.5;
motor_d_eje = 5;
motor_tapa_ancho = 17;
motor_tapa_saliente = 3;
// Polea GT2 20T comprada (agujero 5 mm, correa 6 mm)
dientes_polea_motriz = 20;
polea20_d_brida = 18;
polea20_alto_total = 16;
polea20_alto_cubo = 7;
polea20_d_cubo = 13;
polea20_espesor_brida = 1;
// Perfil GT2
paso_gt2 = 2;
profundidad_diente_gt2 = 0.75;
pld_gt2 = 0.254;
espesor_correa_gt2 = 1.38;   // espesor total de la correa GT2 (catálogo)
radio_hueco_gt2 = 0.555;
// Relación interna real del 28BYJ-48
relacion_motor = (32/9)*(22/11)*(26/9)*(31/10);
medios_pasos_motor = 64;
medios_pasos_por_segundo_max = 900;   // velocidad máxima fiable del 28BYJ-48 (tabla del firmware)
// Rango de la altura: fuera de él, el láser choca (V-07)
angulo_altura_min = -10;
angulo_altura_max = 95;

// ---------- Constantes internas de diseño ----------
espesor_carro = 3;
piso_munon = 2.2;              // piso que retiene la cabeza M8 dentro del muñón
margen_punta_perno = 0.5;      // la punta del perno del lado motor queda antes del interior del tubo
holgura_munon_brazo = 0.5;
labio_608_min = 3;             // labio interior mínimo que apoya el aro exterior del 608 en el brazo
d_labio_608 = 16;              // agujero del labio (no toca el aro interior)
d_contacto_aro = 11.5;         // anillos y arandelas que apoyan SOLO en el aro interior (< rod608_d_aro_int)
holgura_pcb = 0.2;             // holgura vertical de las placas bajo el labio de sus soportes
// Conectores y cables (009, research R1–R5)
holgura_conector = 1;          // entre un conector (con la curva de su cable) y lo que tenga cerca
holgura_techo_tapa = 2;        // entre lo más alto bajo la tapa y su techo
holgura_usb = 0.75;            // entre la funda del enchufe USB y la abertura de la tapa
reserva_cable_motor = 20;      // cable de motor que queda para el enchufe y la curva dentro de la tapa
paso_pines = 2.54;
separacion_filas_esp32 = 22.86; // entre las dos filas de pines del ESP32 (NodeMCU-32S: 0,9")
alto_conector_usb_esp32 = 3;   // conector USB soldado sobre el ESP32
pad_soporte_esp32 = 2.5;       // largo de los 2 apoyos bajo los extremos del ESP32
pierna_soporte = 5;            // largo de cada lado de los postes en L de los soportes
pad_soporte = 3;               // apoyos de las esquinas bajo las placas bajas
alto_labio_soporte = 1;        // labio con chaflán de los postes, sobre el borde de la placa
ancho_entrada_cable = 8;       // entradas de los cables de los motores en la pared −X de la tapa
alto_entrada_cable = 6;
// Barra de distribución (010, research R2 y R5)
destinos_5v = 5;               // ESP32 VIN, 2 × ULN2003, relé VCC y relé COM
destinos_gnd = 5;              // ESP32, 2 × ULN2003, relé y regulador IN−
masa_barra_g = 3;
pad_soporte_barra = 2;         // apoyos de las esquinas: dejan libre la soldadura del agujero 2
altura_libre_central = 5;
eps = 0.01;
cama_max = 200;
plataforma_max = 196;
holgura_zonas = 2;
altura_max_canal = 4;
pared_canal = 1.6;
ancho_canal = 8;
d_interruptor = 6.2;           // interruptor de palanca miniatura con rosca M6
pared_max_interruptor = 4;
distancia_min_cable_correa = 5;
// Pares (R9)
par_motor_mNm = 34;
rendimiento_correa = 0.9;
g_gravedad = 9.81;
// Masas estimadas para el centro de masa (R9), en gramos
masa_powerbank_g = 226;
masa_motor_g = 35;
masa_placas_g = 45;
masa_cuna_g = 60;
masa_polea20_g = 8;
masa_carro_g = 6;
masa_polea80_g = 20;
masa_brazo_g = 30;
masa_bolsillo_g = 15;
densidad_petg = 1.27e-3;       // g/mm³
relleno_medio = 0.5;           // fracción sólida media de una pieza impresa
// Base (adaptador del trípode)
piso_base = 4;
libre_tornillo_tripode = 6;    // espacio libre para la punta del tornillo del trípode
d_camara = 26;
ancho_ventana = 24;
alto_brida_sup = 2.0;          // pestaña superior: chaflán a 45° (1,75 mm) + 0,25 mm recto
espesor_brida = 1;
chaflan_base = 1;
// Plataforma
borde_plataforma = 3;
radio_esquina_plataforma = 6;
d_cubo_plataforma = 26;
pared_marco = 3;
alto_marco = 10;
pared_bolsillo = 2;
alto_bolsillo = 30;
alto_bolsillo_usb = 8;         // pared baja del extremo del conector USB del power bank
alto_interruptor = 12;
espesor_soporte_interruptor = 3;
ancho_soporte_interruptor = 20;
alto_sobrante_cables = 25;
largo_oreja_tapa = 7;
largo_puente_brida = 8;
ancho_puente_brida = 4;
alto_puente_brida = 3.5;
paso_brida = 2.3;
x_puente_brida_az = 20;
ancho_oreja_tapa = 10;
espesor_oreja_tapa = 3;
y_conducto = -30;
alto_tope = 10;
largo_tope = 8;
ancho_tope = 12;
separacion_tope = 2;
alto_soporte_placa = 3;
espesor_pcb = 1.6;
pared_soporte = 1.6;
labio_soporte = 0.6;
// El ESP32 va elevado con los pines hacia abajo; su altura sale de los conectores (009)
alto_modulo_esp32 = 4;
alto_borde_tapa = 3;           // reborde de la plataforma que guía la tapa
pared_tapa = 2;
techo_tapa = 2;
holgura_tapa_carro = 2;
d_contrapeso = m8_tuerca_ec / cos(30) + 2*holgura_tuerca;
tuercas_contrapeso = 4;
alto_tuerca_m8 = 6.5;
// Brazos
pared_alojamiento_608 = 5;
d_pilar = 9;
d_cubo_polea_alt = 14;
separacion_tornillos_pie = 20;
prof_tornillo_pie = 12;
dist_tuerca_pie = 6;
d_agujero_cable_brazo = 4;
dist_agujero_cable = 22;
ancho_canal_brazo = 3;
prof_canal_brazo = 2.5;
ancho_canal_motor = 6;
prof_canal_motor = 3;
// Cuna
alto_anillo_colim = 6;
sobre_anillo_colim = 3.5;      // engrosamiento radial de los anillos de colimación (prisioneros M3 roscados)
largo_prisionero = 8;          // prisionero M3 × 8 de colimación (queda embutido en el anillo)
holgura_anillo_brazo = 1.5;    // separación mínima entre los anillos de la cuna y los brazos
d_munon = 22;
largo_ventana_pulsador = 16;
ancho_ventana_pulsador = 12;
dist_ventana_pulsador = 25;
// Polea de altura
d_aligerado = 8;
material_min_aligerado = 4;
// Láser sin batería (006: research.md R1–R7)
m10_tuerca_ec = 17;            // tuerca DIN 934 M10 (lastre)
m10_tuerca_alto = 8;
masa_tuerca_m10_g = 11;
largo_prisionero_tapa = 12;    // prisionero DIN 914 M3 × 12, punta cónica
iso7380_m3_cabeza_d = 5.7;     // tornillo M3 × 8 de cabeza alomada (contacto +)
iso7380_m3_cabeza_alto = 1.65;
largo_tornillo_contacto = 8;
espesor_ojal = 0.8;            // terminal de ojal M3
d_ext_ojal = 6;                // aro del terminal de ojal M3 (013, research R3)
d_int_ojal = 3.2;
ancho_lengueta_ojal = 3;       // el caño del terminal se corta y el hilo rojo se suelda en la lengüeta
compresion_resorte = 2;        // compresión del resorte del cabezal con la pila falsa puesta
pared_min_tubo_laser = 0.5;    // pared del tubo de aluminio del láser alrededor del hueco de la batería
d_hilo = 1.3;                  // hilo de silicona de 26 AWG
ohm_por_m_26awg = 0.134;
corriente_laser_a = 0.5;       // peor caso de un 303 verde
largo_cable_laser = 600;       // del regulador a la cola del láser
angulo_cable = 150;            // ángulo del cable en el plano de impresión de la cuna (−X, 30° bajo la horizontal)
ancho_ranura_canaleta = 2.8;    // 2 hilos de 26 AWG lado a lado
prof_canaleta = 2.8;
pared_canaleta = 1.2;
puentes_canaleta = 3;
alto_puente_canaleta = 2;
prof_ranura_cable = 2;         // ranuras del hilo en la pila falsa y en el escalón de la tapa
ancho_ranura_cable_tapa = 2.4;
prof_tuerca_contacto = 4;      // de la cara delantera de la pila a la tuerca del contacto
piso_tapa_trasera = 1.6;
pared_tapa_trasera = 2.4;
espesor_resalte_prisionero = 4;
ancho_resalte_prisionero = 8;
desfase_prisionero_tapa = 45;  // el prisionero del negativo va a angulo_cable + 45°, fuera de la salida del cable
alto_min_cuello_tapa = 6;      // tramo macizo mínimo bajo el escalón (lleva el paso de la brida)
ancho_ventana_cable = 3;
alto_ventana_cable = 4;
ancho_grapa = 5;
pared_grapa = 2;
abertura_grapa = 100;          // abertura del anillo de la grapa, en grados
recorrido_equilibrado = 3.5;     // lo que se puede correr el láser hacia cada lado para equilibrarlo
masa_grapa_g = 2;
masa_cable_g = 4;
masa_regulador_g = 5;
alto_brazo_max_flexion = 131;  // límite del criterio de flexión de 0,1° (research 006, R5)

// ---------- Valores derivados (Entidad 3 de data-model.md) ----------
function largo_estandar(x) = ceil(x/5)*5;   // largos comerciales de perno cada 5 mm

// Poleas y correa
d_primitivo_motriz = dientes_polea_motriz*paso_gt2/PI;
d_primitivo_conducida = dientes_polea_conducida*paso_gt2/PI;
d_exterior_conducida = d_primitivo_conducida - 2*pld_gt2;
function largo_correa_abierta(c) =
    let(dd = d_primitivo_conducida - d_primitivo_motriz, fi = asin(dd/(2*c)))
    2*c*cos(fi) + PI*(d_primitivo_motriz + d_primitivo_conducida)/2 + dd*fi*PI/180;
function biseccion_centros(a, b, n) =
    n == 0 ? (a+b)/2
    : (largo_correa_abierta((a+b)/2) > largo_correa ? biseccion_centros(a, (a+b)/2, n-1)
                                                    : biseccion_centros((a+b)/2, b, n-1));
distancia_centros = biseccion_centros(
    (d_primitivo_conducida - d_primitivo_motriz)/2 + 0.5, 200, 60);
relacion_correa = dientes_polea_conducida/dientes_polea_motriz;
pasos_por_vuelta_eje = relacion_motor*medios_pasos_motor*relacion_correa;
pasos_por_grado = pasos_por_vuelta_eje/360;
grados_por_paso = 360/pasos_por_vuelta_eje;
velocidad_max_eje = medios_pasos_por_segundo_max/pasos_por_grado;   // °/s en el eje
h_dentado = ancho_correa + 1;

// Cuna y horquilla
labio_608 = espesor_brazo - rod608_ancho;   // el 608 queda enrasado con la cara exterior del brazo
diametro_interior_cuna = diametro_laser + 2*holgura_colimacion;
radio_exterior_cuna = diametro_interior_cuna/2 + pared_tubo_cuna;
largo_munon = m8_cabeza_alto + holgura_tuerca - pared_tubo_cuna + piso_munon;
semiancho_interior_horquilla = radio_exterior_cuna + largo_munon + holgura_munon_brazo;

// Láser sin batería (006, data-model Entidad 3). Distancias a lo largo del eje del láser desde el
// borde trasero del tubo, positivas hacia el frente.
largo_laser_sin_tapa = largo_laser - largo_tapa_original;
prof_lastre = tuercas_lastre_tapa > 0 ? tuercas_lastre_tapa*m10_tuerca_alto + holgura("presion") : 0;
largo_tapa_fuera = piso_tapa_trasera + max(prof_lastre, alto_min_cuello_tapa);
largo_tapa_trasera = largo_tapa_fuera + largo_zona_tapa;
largo_laser_mod = largo_laser_sin_tapa + largo_tapa_fuera;
d_pila_falsa = diametro_hueco_bateria - 2*holgura("suelto");
largo_pila_falsa = profundidad_hueco_bateria + compresion_resorte - iso7380_m3_cabeza_alto - espesor_ojal;
d_paso_hilo = d_hilo + 1.1;
r_esquina_tuerca_contacto = (m3_tuerca_ec + holgura_tuerca)/cos(30)/2;
// Agujero del hilo en la pila falsa: a mitad de camino entre la tuerca del contacto y la pared mínima
descentrado_hilo_pila = (r_esquina_tuerca_contacto + 0.4 + d_paso_hilo/2 + d_pila_falsa/2 - espesor_min_pared - d_paso_hilo/2)/2;
r_funda_int = diametro_zona_tapa/2 + holgura("deslizante");
r_funda_ext = r_funda_int + pared_tapa_trasera;
ec_lastre = m10_tuerca_ec + 2*holgura("presion");
r_esquina_lastre = ec_lastre/2/cos(30);
plastico_prisionero = pared_tapa_trasera + espesor_resalte_prisionero;
saliente_prisionero = largo_prisionero_tapa - plastico_prisionero - holgura("deslizante");
r_tapa_trasera = r_funda_ext + espesor_resalte_prisionero + saliente_prisionero;   // en los prisioneros
z_prisioneros_tapa = largo_tapa_fuera + largo_zona_tapa/2;   // desde la cara trasera de la tapa
masa_pila_falsa_g = PI*pow(d_pila_falsa/2, 2)*largo_pila_falsa*densidad_petg*relleno_medio + 1.5;
vol_tapa_trasera = PI*pow(r_funda_ext, 2)*largo_tapa_trasera - PI*pow(r_funda_int, 2)*largo_zona_tapa
                   - (tuercas_lastre_tapa > 0 ? 3*sqrt(3)/2*pow(r_esquina_lastre, 2)*prof_lastre : 0);
masa_tapa_trasera_g = vol_tapa_trasera*densidad_petg*relleno_medio + 2;   // + 2 prisioneros con tuerca
masa_lastre_g = tuercas_lastre_tapa*masa_tuerca_m10_g;
x_cable_grapa = largo_zona_tapa + 8;
masas_laser_mod = [   // [masa, posición desde el borde trasero del tubo]
    [masa_laser_g, distancia_trasera_centro_masa - largo_tapa_original],
    [-masa_bateria_g, profundidad_hueco_bateria/2],
    [-masa_tapa_original_g, -largo_tapa_original/2],
    [masa_pila_falsa_g, largo_pila_falsa/2],
    [masa_lastre_g, -largo_tapa_fuera + piso_tapa_trasera + prof_lastre/2],
    [masa_tapa_trasera_g, (largo_zona_tapa - largo_tapa_fuera)/2],
    [masa_grapa_g + masa_cable_g, x_cable_grapa]];
masa_laser_mod_g = sum_lista([for (m = masas_laser_mod) m[0]]);
cm_mod_desde_borde = sum_lista([for (m = masas_laser_mod) m[0]*m[1]])/masa_laser_mod_g;
caida_cable_v = 2*largo_cable_laser/1000*ohm_por_m_26awg*corriente_laser_a;

// Conectores (009): un Dupont conectado ocupa la tira, su cuerpo y la curva del cable
curva_cable = radio_curva_cable + diametro_cable_dupont;
alto_dupont_conectado = alto_tira_pines + largo_dupont + curva_cable;
elevacion_esp32 = alto_dupont_conectado + holgura_conector;   // los Dupont del ESP32 van hacia abajo
alto_conectores_arriba = alto_soporte_placa + espesor_pcb + alto_dupont_conectado;   // ULN2003 y relé
alto_enchufes_motor = alto_soporte_placa + espesor_pcb + alto_enchufe_motor + curva_cable;
alto_esp32_total = elevacion_esp32 + espesor_pcb + alto_modulo_esp32;
alto_interior_tapa = max(altura_placas, alto_conectores_arriba, alto_esp32_total) + holgura_techo_tapa;
alto_tapa = alto_interior_tapa + techo_tapa;
// Carro del motor: borde exterior medido desde el eje del motor (ver más abajo)
carro_x_max = motor_desplazamiento_eje + motor_d_cuerpo/2 + motor_tapa_saliente + 2;

// Barrido del láser y altura del eje de altura (sobre la cara superior de la plataforma)
l_trasero = distancia_trasera_centro_masa_nueva > 0 ? distancia_trasera_centro_masa_nueva
                                                     : cm_mod_desde_borde + largo_tapa_fuera;
l_delantero = largo_laser_mod - l_trasero;
hueco_equilibrado = l_trasero - largo_tapa_trasera - largo_tubo_cuna/2;
radio_barrido = max(l_trasero + r_funda_ext*sin(5), l_delantero + diametro_laser/2*sin(5));
altura_eje_barrido = radio_barrido + holgura_barrido + altura_libre_central;
// El carro del motor de altura (en el brazo, debajo del eje) tiene que quedar por encima del motor de
// azimut y de la tapa de la electrónica: con un láser corto, esto manda sobre el barrido
altura_eje_motores = distancia_centros + carro_x_max
                     + max(recorrido_tensor + espesor_carro + motor_alto_cuerpo + holgura_zonas,
                           alto_tapa + holgura_tapa_carro) + 1;
altura_eje = max(altura_eje_barrido, altura_eje_motores);
alto_brazo = altura_eje + rod608_d_ext/2 + pared_alojamiento_608 + 1;

// Carro del motor (sistema del carro: eje del motor en el origen, +X hacia afuera de la polea conducida)
carro_x_min = -(motor_d_resalte/2 + holgura_encastre + 3);
ranura_carro_x = motor_desplazamiento_eje;
ranura_carro_y = motor_entre_orejas/2 + motor_d_oreja/2 + 2 + d_pilar/2;
carro_semiancho = ranura_carro_y + d_pilar/2 + 1;

// Motor de altura (cotas X del lado del motor)
alto_pilar_motor = motor_alto_cuerpo + 2;
x_cara_ext_brazo = semiancho_interior_horquilla + espesor_brazo;
x_cara_int_carro_alt = x_cara_ext_brazo + alto_pilar_motor;
x_inicio_cubo20_alt = x_cara_int_carro_alt + espesor_carro;
plano_correa_altura = x_inicio_cubo20_alt + polea20_alto_cubo + polea20_espesor_brida + ancho_correa/2 + 0.5;
largo_cubo_polea_altitud = plano_correa_altura - ancho_correa/2 - 0.5 - polea20_espesor_brida - x_cara_ext_brazo;
x_ext_polea_alt = plano_correa_altura + h_dentado/2 + espesor_brida;
// Marcas de altura (012): disco de la escala sobre la polea y aguja de índice del brazo del motor
r_borde_polea_alt = d_exterior_conducida/2 + espesor_brida;          // radio de las pestañas
r_raiz_polea_alt = d_exterior_conducida/2 - profundidad_diente_gt2;
r_hex_polea_alt = (m8_tuerca_ec + holgura_tuerca)/cos(30)/2;
r_aligerado = (r_hex_polea_alt + r_raiz_polea_alt)/2;                 // aligerados a 30° + k·60°
r_exterior_disco_escala = r_borde_polea_alt;
r_agujeros_disco = r_aligerado;                                       // agujeros guía a 0° y 180°
r_aguja_int = r_borde_polea_alt + holgura_aguja;
r_aguja_ext = r_aguja_int + seccion_aguja[0];
x_punta_aguja = x_ext_polea_alt + espesor_disco_escala;               // plano de la escala
alto_aguja = x_punta_aguja - x_cara_ext_brazo;
r_correa_ext_alt = d_primitivo_conducida/2 + espesor_correa_gt2 - pld_gt2;   // cara exterior de la correa
alto_brazo_motor = max(alto_brazo, altura_eje + r_aguja_ext + espesor_min_pared);
// Marcas de azimut (012): con el láser hacia +Y (posición modelada) apunta al sur
azimut_reposo = 180;          // azimut de brújula del láser en la posición modelada (+Y = sur)
angulo_marca_sur = 90;        // ángulo de la «S» en el plano XY (desde +X, antihorario): +Y
angulo_marca_oeste = angulo_marca_sur - 90;   // 90° en sentido horario visto desde arriba: +X
x_dientes_polea20_alt = x_inicio_cubo20_alt + polea20_alto_cubo + polea20_espesor_brida + h_dentado/2;
eje_en_cubo20 = motor_largo_eje - espesor_carro;

// Eje de azimut: pila vertical de la base (de abajo hacia arriba)
dz_correa_azimut = -(polea20_alto_cubo - espesor_plataforma) - polea20_espesor_brida - ancho_correa/2 - 0.5;
alto_arandela_contacto = -dz_correa_azimut - h_dentado/2 - alto_brida_sup;
espesor_cubo_plataforma = m8_cabeza_alto + 0.3 + 2;
largo_fijo_azimut = 2 + alto_arandela_contacto + 2*rod608_ancho + separacion_608_azimut;
largo_perno_azimut = largo_estandar(largo_fijo_azimut + alto_arandela_contacto + m8_autoblocante_alto + 2);
altura_camara = (largo_perno_azimut - largo_fijo_azimut) + libre_tornillo_tripode;
z_tuerca_tripode_sup = piso_base + tuerca_3_8_alto + holgura_tuerca;
z_camara_sup = z_tuerca_tripode_sup + altura_camara;
z_resalte_inf = z_camara_sup + rod608_ancho;
z_resalte_sup = z_resalte_inf + separacion_608_azimut;
z_tope_base = z_resalte_sup + rod608_ancho;
z_dentado_sup = z_tope_base - alto_brida_sup;
z_dentado_inf = z_dentado_sup - h_dentado;
z_centro_dentado_base = (z_dentado_sup + z_dentado_inf)/2;
z_brida_inf_base = z_dentado_inf - espesor_brida;
z_cuerpo_base_sup = z_brida_inf_base - (diametro_apoyo_tripode/2 - (d_exterior_conducida/2 + espesor_brida));
z_plataforma_inf = z_tope_base + alto_arandela_contacto;
z_plataforma_sup = z_plataforma_inf + espesor_plataforma;
z_dientes_polea20_az = z_plataforma_inf + dz_correa_azimut;
z_polea20_az_inf = z_plataforma_sup - polea20_alto_total;
z_eje_altura = z_plataforma_sup + altura_eje;
largo_separador_azimut = separacion_608_azimut - 0.1;   // 0,1 mm menos que el resalte: precarga

// Pernos del eje de altura: en cada muñón, una tuerca M8 común (entra por el tubo) y un perno desde
// afuera; un perno de cabeza adentro no entra en un tubo de 20 mm. Lado del motor: la cabeza va en el
// hexágono de la polea, cuya profundidad ajusta el largo comercial para que la punta llegue a
// margen_punta_perno del tubo (alcanza con que el hexágono tome la mitad de la cabeza). Lado del cable:
// la cabeza apoya en la arandela de contacto, cuyo alto ajusta el largo comercial de la misma manera.
x_tuerca_m8_cuna = diametro_interior_cuna/2 + m8_tuerca_alto;   // fondo del alojamiento (abierto al tubo)
x_punta_perno_alt_motor = diametro_interior_cuna/2 + margen_punta_perno;
largo_perno_alt_motor = largo_estandar(x_ext_polea_alt - x_punta_perno_alt_motor - m8_cabeza_alto);
prof_cabeza_polea_alt = x_ext_polea_alt - x_punta_perno_alt_motor - largo_perno_alt_motor;
rosca_tuerca_munon = x_tuerca_m8_cuna - x_punta_perno_alt_motor;
largo_perno_alt_cable = largo_estandar(x_cara_ext_brazo + alto_arandela_contacto - x_punta_perno_alt_motor);
alto_arandela_cable = largo_perno_alt_cable - (x_cara_ext_brazo - x_punta_perno_alt_motor);

// Topes tensores (distancia desde el eje conducido)
r_carro_int = distancia_centros + carro_x_min;
r_tope_ext = r_carro_int - recorrido_tensor - separacion_tope;   // el carro puede acercarse recorrido_tensor
r_tope_int = r_tope_ext - largo_tope;

// ---------- Disposición en planta (R5 con la corrección de la implementación) ----------
// Zona: [x0, y0, x1, y1, altura sobre la cara superior de la plataforma, "nombre"]
x_marco_int = semiancho_interior_horquilla - holgura_encastre - pared_marco;
x_marco_ext = x_cara_ext_brazo + holgura_encastre + pared_marco;
y_marco = ancho_brazo/2 + holgura_encastre + pared_marco;
// Columnas de placas (+X)
x_col_a0 = x_marco_ext + holgura_zonas + pared_tapa + holgura_encastre;
ancho_col_a = uln2003_ancho + 2*holgura_encastre + 2*pared_soporte;
x_col_a1 = x_col_a0 + ancho_col_a;
x_col_b0 = x_col_a1 + holgura_zonas;
ancho_col_b = max(esp32_ancho, rele_ancho) + 2*holgura_encastre + 2*pared_soporte;
x_col_b1 = x_col_b0 + ancho_col_b;
largo_soporte_uln = uln2003_largo + 2*holgura_encastre + 2*pared_soporte;
largo_soporte_esp32 = esp32_largo + 2*holgura_encastre + 2*pared_soporte;
largo_soporte_rele = rele_largo + 2*holgura_encastre + 2*pared_soporte;
largo_soporte_regulador = regulador_largo + 2*holgura_encastre + 2*pared_soporte;
// Barra de distribución (010, research R1): al lado (+X) del regulador, en la columna de los ULN2003
ancho_soporte_barra = barra_ancho + 2*holgura_encastre + 2*pared_soporte;
largo_soporte_barra = barra_largo + 2*holgura_encastre + 2*pared_soporte;
alto_col_a = 2*largo_soporte_uln + largo_soporte_regulador + 2*holgura_zonas;
alto_col_b = largo_soporte_esp32 + largo_soporte_rele + holgura_zonas;
y_uln_alt0 = -alto_col_a/2;
y_uln_az0 = y_uln_alt0 + largo_soporte_uln + holgura_zonas;
y_reg0 = y_uln_az0 + largo_soporte_uln + holgura_zonas;
y_esp32_0 = -alto_col_b/2;
y_rele_0 = y_esp32_0 + largo_soporte_esp32 + holgura_zonas;
x_reg1 = x_col_a0 + regulador_ancho + 2*holgura_encastre + 2*pared_soporte;
x_barra0 = x_reg1 + holgura_zonas;
y_barra0 = y_reg0;
x_tapa0 = x_col_a0 - holgura_encastre - pared_tapa;
// ESP32 en su celda: borde en X y centro; filas de Dupont (largo y separación de los apoyos)
x_esp32_0 = x_col_b0 + pared_soporte + holgura_encastre;
x_esp32_c = x_esp32_0 + esp32_ancho/2;
largo_fila_esp32 = pines_por_lado_esp32*paso_pines;
ancho_franja_esp32 = (esp32_ancho - separacion_filas_esp32)/2 + paso_pines/2 + curva_cable;
// El ESP32 apoya en los extremos de la franja central, entre las curvas de los Dupont: las filas de pines
// pueden ocupar todo el largo de la placa (NodeMCU-32S: 19 × 2,54 = 48,3 mm)
ancho_apoyo_esp32 = esp32_ancho - 2*ancho_franja_esp32 - 2*holgura_conector;
// Abertura USB de la tapa: centrada en el conector del ESP32 (009, research R5)
z_usb_esp32 = elevacion_esp32 + espesor_pcb + alto_conector_usb_esp32/2;
ancho_abertura_usb = ancho_enchufe_usb + 2*holgura_usb;
alto_abertura_usb = alto_enchufe_usb + 2*holgura_usb;
x_tapa1 = x_col_b1 + holgura_encastre + pared_tapa;
y_tapa0 = min(y_uln_alt0, y_esp32_0) - holgura_encastre - pared_tapa;
// Hueco para el cable sobrante (FR-012) e interruptor general (FR-013), dentro de la tapa
y_sob0 = max(y_reg0 + largo_soporte_regulador, y_rele_0 + largo_soporte_rele, y_barra0 + largo_soporte_barra) + holgura_zonas;
y_sob1 = y_sob0 + alto_sobrante_cables;
x_interruptor = x_col_b1 - espesor_soporte_interruptor;
y_interruptor = (y_sob0 + y_sob1)/2;
y_tapa1 = y_sob1 + holgura_encastre + pared_tapa;
// Entradas de los cables de los motores en la pared −X de la tapa
y_entrada_motor_alt = 0;                     // frente al canal del brazo motor
y_entrada_motor_az = (y_sob0 + y_sob1)/2;    // a la altura del hueco del sobrante
// Power bank (−X), centrado en Y para equilibrar el grupo del motor de azimut
x_pb0 = -x_marco_ext - holgura_zonas;
ancho_bolsillo = powerbank_alto + 2*holgura_encastre + 2*pared_bolsillo;
x_pb1 = x_pb0 - ancho_bolsillo;
largo_bolsillo = powerbank_largo + 2*holgura_encastre + 2*pared_bolsillo;
masa_grupo_az_g = masa_motor_g + masa_polea20_g + masa_carro_g;
y_pb_c = -masa_grupo_az_g*(distancia_centros + motor_desplazamiento_eje)/(masa_powerbank_g + masa_bolsillo_g);
y_pb0 = y_pb_c - largo_bolsillo/2;
y_pb1 = y_pb_c + largo_bolsillo/2;
// Carro y tope del motor de azimut (+Y)
y_carro_az0 = distancia_centros + carro_x_min - recorrido_tensor;
y_carro_az1 = distancia_centros + carro_x_max + recorrido_tensor;
// Contrapeso (esquina −X, +Y)
x_contrapeso = x_pb1 + d_contrapeso/2 + 2;
y_contrapeso = y_pb1 + holgura_zonas + d_contrapeso/2 + 2;

zona_cubo = [-d_cubo_plataforma/2, -d_cubo_plataforma/2, d_cubo_plataforma/2, d_cubo_plataforma/2,
             espesor_cubo_plataforma - espesor_plataforma, "cubo central"];
zona_brazo_motor = [x_marco_int, -y_marco, x_marco_ext, y_marco, alto_marco, "brazo motor"];
zona_brazo_cable = [-x_marco_ext, -y_marco, -x_marco_int, y_marco, alto_marco, "brazo cable"];
zona_motor_azimut = [-carro_semiancho, y_carro_az0, carro_semiancho, y_carro_az1,
                     espesor_carro + motor_alto_cuerpo, "motor azimut"];
zona_tope_azimut = [-ancho_tope/2, r_tope_int, ancho_tope/2, r_tope_ext, alto_tope, "tope azimut"];
zona_powerbank = [x_pb1, y_pb0, x_pb0, y_pb1, powerbank_ancho, "powerbank"];
zona_uln_altura = [x_col_a0, y_uln_alt0, x_col_a1, y_uln_alt0 + largo_soporte_uln, altura_placas, "uln altura"];
zona_uln_azimut = [x_col_a0, y_uln_az0, x_col_a1, y_uln_az0 + largo_soporte_uln, altura_placas, "uln azimut"];
zona_esp32 = [x_col_b0, y_esp32_0, x_col_b1, y_esp32_0 + largo_soporte_esp32, alto_esp32_total, "esp32"];
zona_rele = [x_col_b0, y_rele_0, x_col_b1, y_rele_0 + largo_soporte_rele, altura_placas, "rele"];
zona_regulador = [x_col_a0, y_reg0, x_reg1, y_reg0 + largo_soporte_regulador, altura_placas, "regulador"];
zona_barra = [x_barra0, y_barra0, x_barra0 + ancho_soporte_barra, y_barra0 + largo_soporte_barra, altura_placas, "barra"];
y_puente_brida_az = y_carro_az1 + holgura_zonas + ancho_puente_brida/2 + 1;   // brida del cable del motor de azimut
zona_sobrante_cables = [x_col_a0, y_sob0, x_col_b1, y_sob1, 0, "sobrante de cables"];
zona_tapa = [x_tapa0, y_tapa0 - largo_oreja_tapa, x_tapa1, y_tapa1 + largo_oreja_tapa, alto_tapa, "tapa"];
zona_conducto = [x_pb0, y_conducto - ancho_canal/2 - pared_canal, x_tapa0,
                 y_conducto + ancho_canal/2 + pared_canal, altura_max_canal, "conducto"];
zona_contrapeso = [x_contrapeso - d_contrapeso/2, y_contrapeso - d_contrapeso/2,
                   x_contrapeso + d_contrapeso/2, y_contrapeso + d_contrapeso/2,
                   tuercas_contrapeso*alto_tuerca_m8 + 1, "contrapeso"];

zonas_componentes = concat(
    [zona_cubo, zona_brazo_motor, zona_brazo_cable, zona_motor_azimut, zona_tope_azimut,
     zona_powerbank, zona_uln_altura, zona_uln_azimut, zona_esp32, zona_rele, zona_regulador, zona_barra],
    con_contrapeso ? [zona_contrapeso] : []);
zonas_todas = concat(zonas_componentes, [zona_tapa, zona_conducto]);

function minimo(v) = min([for (x = v) x]);
function maximo(v) = max([for (x = v) x]);
x_plat0 = minimo([for (z = zonas_todas) z[0]]) - borde_plataforma;
x_plat1 = maximo([for (z = zonas_todas) z[2]]) + borde_plataforma;
y_plat0 = minimo([for (z = zonas_todas) z[1]]) - borde_plataforma;
y_plat1 = maximo([for (z = zonas_todas) z[3]]) + borde_plataforma;
largo_plataforma = x_plat1 - x_plat0;
ancho_plataforma = y_plat1 - y_plat0;

// Solapamiento de dos zonas (con separación g)
function solapan(a, b, g) = !(a[2] + g <= b[0] || b[2] + g <= a[0] || a[3] + g <= b[1] || b[3] + g <= a[1]);
choques_componentes = [for (i = [0:len(zonas_componentes)-1]) for (j = [0:len(zonas_componentes)-1])
    if (j > i && solapan(zonas_componentes[i], zonas_componentes[j], holgura_zonas))
        str(zonas_componentes[i][5], " ↔ ", zonas_componentes[j][5])];
choques_tapa = [for (z = [zona_cubo, zona_brazo_motor, zona_brazo_cable, zona_motor_azimut,
                          zona_tope_azimut, zona_powerbank, zona_contrapeso])
    if (solapan(z, zona_tapa, 0)) z[5]];
choques_conducto = [for (z = [zona_cubo, zona_brazo_motor, zona_brazo_cable, zona_motor_azimut, zona_tope_azimut])
    if (solapan(z, zona_conducto, 0)) z[5]];

// Barrido del láser (V-07): secciones del láser y del tubo de la cuna cada 5 mm, de angulo_altura_min a
// angulo_altura_max.
// Cada sección es un disco perpendicular al eje del láser: su punto más bajo está r·|cos a| por
// debajo del centro y se extiende r·|sin a| en Y.
// La cola es la tapa trasera impresa (006): radio r_funda_ext, y r_tapa_trasera en la sección de los
// prisioneros (con su contratuerca), que se agrega aparte porque el paso de 5 mm podría saltearla.
function radio_laser(t) = t <= -l_trasero + largo_tapa_trasera ? r_funda_ext : diametro_laser/2;
t_prisioneros = -l_trasero + z_prisioneros_tapa;
function secciones(a) = concat(
    [for (t = [-l_trasero:5:l_delantero]) [t*cos(a), altura_eje + t*sin(a), radio_laser(t)]],
    [for (t = [t_prisioneros - ancho_resalte_prisionero/2, t_prisioneros, t_prisioneros + ancho_resalte_prisionero/2])
        [t*cos(a), altura_eje + t*sin(a), r_tapa_trasera]],
    [for (t = [-largo_tubo_cuna/2:5:largo_tubo_cuna/2]) [t*cos(a), altura_eje + t*sin(a), radio_exterior_cuna + sobre_anillo_colim]],
    [[-l_trasero*cos(a), altura_eje - l_trasero*sin(a), r_funda_ext],
     [l_delantero*cos(a), altura_eje + l_delantero*sin(a), diametro_laser/2]]);
function holgura_barrido_zona(z) = minimo(concat([999], [for (a = [angulo_altura_min:1:angulo_altura_max]) for (s = secciones(a))
    if (z[0] < s[2] && z[2] > -s[2] && s[0] + s[2]*abs(sin(a)) > z[1] && s[0] - s[2]*abs(sin(a)) < z[3])
        s[1] - s[2]*abs(cos(a)) - z[4]]));
choques_barrido = [for (z = concat(zonas_todas, [[-ancho_tope/2, r_tope_int, ancho_tope/2, r_tope_ext, alto_tope, "tope"]]))
    if (holgura_barrido_zona(z) < 2) str(z[5], " (", holgura_barrido_zona(z), " mm)")];

// Centro de masa de la parte giratoria (R9): [masa_g, x, y]
area_plataforma = largo_plataforma*ancho_plataforma;
masa_plataforma_g = area_plataforma*espesor_plataforma*densidad_petg*relleno_medio + 40;
masa_tapa_g = (2*((x_tapa1-x_tapa0)+(y_tapa1-y_tapa0))*alto_tapa*pared_tapa
               + (x_tapa1-x_tapa0)*(y_tapa1-y_tapa0)*techo_tapa)*densidad_petg;
masas_giratorias = [
    [masa_powerbank_g + masa_bolsillo_g, (x_pb0+x_pb1)/2, y_pb_c],
    [10, (x_col_a0+x_col_a1)/2, y_uln_alt0 + largo_soporte_uln/2],
    [10, (x_col_a0+x_col_a1)/2, y_uln_az0 + largo_soporte_uln/2],
    [masa_placas_g - 35, (x_col_b0+x_col_b1)/2, y_esp32_0 + largo_soporte_esp32/2],
    [15, (x_col_b0+x_col_b1)/2, y_rele_0 + largo_soporte_rele/2],
    [masa_regulador_g, (x_col_a0+x_reg1)/2, y_reg0 + largo_soporte_regulador/2],
    [masa_barra_g, x_barra0 + ancho_soporte_barra/2, y_barra0 + largo_soporte_barra/2],
    [masa_tapa_g, (x_tapa0+x_tapa1)/2, (y_tapa0+y_tapa1)/2],
    [masa_grupo_az_g, 0, distancia_centros + motor_desplazamiento_eje],
    [masa_motor_g + masa_carro_g + masa_polea20_g, x_cara_int_carro_alt - motor_alto_cuerpo/2, 0],
    [masa_polea80_g, x_ext_polea_alt - h_dentado, 0],
    [masa_brazo_g, x_cara_ext_brazo - espesor_brazo/2, 0],
    [masa_brazo_g, -(x_cara_ext_brazo - espesor_brazo/2), 0],
    [masa_cuna_g + masa_laser_mod_g, 0, 0],
    [masa_plataforma_g, (x_plat0+x_plat1)/2, (y_plat0+y_plat1)/2]];
masa_giratoria_g = sum_lista([for (m = masas_giratorias) m[0]]);
function sum_lista(v, i = 0) = i >= len(v) ? 0 : v[i] + sum_lista(v, i+1);
x_centro_masa_plataforma = sum_lista([for (m = masas_giratorias) m[0]*m[1]])/masa_giratoria_g;
y_centro_masa_plataforma = sum_lista([for (m = masas_giratorias) m[0]*m[2]])/masa_giratoria_g;
masa_base_g = PI*pow(diametro_apoyo_tripode/2, 2)*z_cuerpo_base_sup*densidad_petg*relleno_medio;
masa_estimada_g = masa_giratoria_g + masa_base_g;

// Pares del eje de altura (FR-024)
par_disponible_mNm = par_motor_mNm*relacion_correa*rendimiento_correa;
par_desbalance_10_mNm = (masa_laser_mod_g + masa_cuna_g)/1000*g_gravedad*10;
par_desbalance_20_mNm = (masa_laser_mod_g + masa_cuna_g)/1000*g_gravedad*20;
fs_par_10 = par_disponible_mNm/par_desbalance_10_mNm;
fs_par_20 = par_disponible_mNm/par_desbalance_20_mNm;

// Presupuesto de error (Entidad 7, research.md R4), en grados
presupuesto_error = [
    ["resolucion azimut", grados_por_paso], ["resolucion altura", grados_por_paso],
    ["repetibilidad caja azimut", 0.1], ["repetibilidad caja altura", 0.1],
    ["correa azimut", 0.1], ["correa altura", 0.1],
    ["inclinacion plataforma", 0.1], ["perpendicularidad ejes", 0.25],
    ["colimacion", 0.2], ["alineacion", 0.3], ["flexion", 0.01], ["hora", 0.05]];
error_rss = sqrt(sum_lista([for (e = presupuesto_error) e[1]*e[1]]));
error_peor_caso = sum_lista([for (e = presupuesto_error) e[1]]);

// Espesores mínimos por pieza (FR-021, V-11)
espesores_minimos = [   // [parámetro principal, valor, pared, espesor]
    ["pared_tubo_cuna", pared_tubo_cuna, "pared del tubo de la cuna", pared_tubo_cuna],
    ["holgura_tuerca", holgura_tuerca, "piso del muñón", piso_munon],
    ["piso_munon", piso_munon, "piso del muñón bajo la tuerca M8", semiancho_interior_horquilla - holgura_munon_brazo - x_tuerca_m8_cuna],
    ["holgura_perno_m8", holgura_perno_m8, "pared del separador", (d_contacto_aro - rod608_d_int - holgura_perno_m8)/2],
    ["holgura_perno_m8", holgura_perno_m8, "pared de la arandela de contacto", (d_contacto_aro - rod608_d_int - holgura_perno_m8)/2],
    ["holgura_perno_m8", holgura_perno_m8, "pared del cubo de la polea de altura", (d_cubo_polea_alt - rod608_d_int - holgura_perno_m8)/2],
    ["ajuste_608", ajuste_608, "labio del 608 en el brazo", (rod608_d_ext + ajuste_608 - d_labio_608)/2],
    ["ajuste_608", ajuste_608, "pared del 608 en el brazo", pared_alojamiento_608 - ajuste_608/2],
    ["dientes_polea_conducida", dientes_polea_conducida, "pared del 608 en la base", (d_exterior_conducida - 2*profundidad_diente_gt2 - rod608_d_ext - ajuste_608)/2],
    ["holgura_tuerca", holgura_tuerca, "pared entre la tuerca 3/8 y la cámara", (d_camara - (tuerca_3_8_ec + holgura_tuerca)/cos(30))/2],
    ["espesor_brazo", espesor_brazo, "pared de la ranura de tuerca del pie", (espesor_brazo - (m3_tuerca_ec + holgura_tuerca)/cos(30))/2],
    ["holgura_colimacion", holgura_colimacion, "rosca del prisionero en el anillo", pared_tubo_cuna + sobre_anillo_colim - holgura_colimacion],
    ["espesor_plataforma", espesor_plataforma, "piso de la plataforma bajo las tuercas M3", espesor_plataforma - (m3_tuerca_alto + 0.2)],
    ["espesor_plataforma", espesor_plataforma, "piso del cubo de la plataforma", espesor_cubo_plataforma - m8_cabeza_alto - 0.3],
    ["holgura_tornillo_m3", holgura_tornillo_m3, "pared del carro junto a las ranuras", carro_semiancho - ranura_carro_y - (m3_d + holgura_tornillo_m3)/2],
    ["pared_bolsillo", pared_bolsillo, "pared del bolsillo", pared_bolsillo],
    ["pared_tapa", pared_tapa, "pared de la tapa", pared_tapa],
    ["pared_canal", pared_canal, "pared del conducto", pared_canal],
    ["espesor_carro", espesor_carro, "espesor del carro", espesor_carro],
    ["material_min_aligerado", material_min_aligerado, "material junto a los aligerados de la polea", material_min_aligerado]];
espesores_bajos = [for (e = espesores_minimos) if (e[3] < espesor_min_pared - 1e-6)   // 1e-6: redondeo
    str(e[0], "=", e[1], ": ", e[2], " = ", e[3], " mm")];

// --- VALIDACIÓN DE PARÁMETROS ---
module comprobar_rango(nombre, v, mn, mx) {
    assert(is_num(v) && v >= mn && v <= mx,
           str(nombre, "=", v, ": fuera de rango [", mn, ", ", mx, "]"));
}
// V-01: rangos
comprobar_rango("diametro_laser", diametro_laser, 20, 40);
comprobar_rango("largo_laser", largo_laser, 120, 260);
comprobar_rango("distancia_trasera_centro_masa", distancia_trasera_centro_masa, 48, 156);
comprobar_rango("masa_laser_g", masa_laser_g, 80, 400);
comprobar_rango("powerbank_largo", powerbank_largo, 60, 150);
comprobar_rango("powerbank_ancho", powerbank_ancho, 40, 75);
comprobar_rango("powerbank_alto", powerbank_alto, 10, 30);
comprobar_rango("esp32_largo", esp32_largo, 48, 60);
comprobar_rango("esp32_ancho", esp32_ancho, 25, 32);
comprobar_rango("rele_largo", rele_largo, 35, 55);
comprobar_rango("rele_ancho", rele_ancho, 17, 30);
comprobar_rango("uln2003_largo", uln2003_largo, 30, 42);
comprobar_rango("uln2003_ancho", uln2003_ancho, 20, 35);
comprobar_rango("altura_placas", altura_placas, 10, 25);
comprobar_rango("dientes_polea_conducida", dientes_polea_conducida, 80, 100);
comprobar_rango("largo_correa", largo_correa, 160, 240);
comprobar_rango("ancho_correa", ancho_correa, 6, 9);
comprobar_rango("recorrido_tensor", recorrido_tensor, 2, 6);
comprobar_rango("ajuste_diente_gt2", ajuste_diente_gt2, -0.15, 0.15);
comprobar_rango("holgura_encastre", holgura_encastre, 0.1, 0.5);
comprobar_rango("holgura_tornillo_m3", holgura_tornillo_m3, 0.1, 0.6);
comprobar_rango("holgura_tuerca", holgura_tuerca, 0.1, 0.4);
comprobar_rango("holgura_perno_m8", holgura_perno_m8, 0.2, 0.8);
comprobar_rango("ajuste_608", ajuste_608, -0.1, 0.3);
comprobar_rango("holgura_barrido", holgura_barrido, 5, 20);
comprobar_rango("espesor_plataforma", espesor_plataforma, 3, 6);
comprobar_rango("espesor_brazo", espesor_brazo, 10, 14);
comprobar_rango("ancho_brazo", ancho_brazo, 30, 45);
comprobar_rango("pared_tubo_cuna", pared_tubo_cuna, 2, 4);
comprobar_rango("largo_tubo_cuna", largo_tubo_cuna, 70, 140);
comprobar_rango("holgura_colimacion", holgura_colimacion, 1, 3);
comprobar_rango("separacion_608_azimut", separacion_608_azimut, 10, 30);
comprobar_rango("diametro_apoyo_tripode", diametro_apoyo_tripode, 60, 90);
comprobar_rango("profundidad_grabado", profundidad_grabado, 0.4, 1);
comprobar_rango("ancho_raya", ancho_raya, 0.8, 1.5);
comprobar_rango("ancho_linea_referencia", ancho_linea_referencia, 0.8, 2);
comprobar_rango("alto_letra", alto_letra, 6, 14);
comprobar_rango("espesor_disco_escala", espesor_disco_escala, 1.6, 3);
comprobar_rango("d_interior_disco_escala", d_interior_disco_escala, 18, 24);
comprobar_rango("giro_ranura_disco", giro_ranura_disco, 20, 40);
comprobar_rango("paso_escala", paso_escala, 5, 30);
comprobar_rango("angulo_escala_max", angulo_escala_max, 45, 95);
comprobar_rango("holgura_aguja", holgura_aguja, 0.5, 6);
assert(is_bool(con_contrapeso), str("con_contrapeso=", con_contrapeso, ": debe ser true o false"));
assert(is_bool(con_ventana_pulsador), str("con_ventana_pulsador=", con_ventana_pulsador, ": debe ser true o false"));

// V-02: centro de masa del láser cerca del medio
assert(distancia_trasera_centro_masa >= 0.4*largo_laser && distancia_trasera_centro_masa <= 0.6*largo_laser,
    str("distancia_trasera_centro_masa=", distancia_trasera_centro_masa, ": debe estar entre ",
        0.4*largo_laser, " y ", 0.6*largo_laser, " (40–60 % de largo_laser); revise la medición del punto de equilibrio"));
// V-03: la plataforma entra en la cama
assert(largo_plataforma <= plataforma_max && ancho_plataforma <= plataforma_max,
    str("powerbank_alto=", powerbank_alto, ": la plataforma mide ", largo_plataforma, " × ", ancho_plataforma,
        " mm (máx. ", plataforma_max, "); reduzca el power bank, las placas o largo_correa"));
// V-04: el brazo (impreso plano) entra en la cama
assert(alto_brazo <= plataforma_max,
    str("largo_laser=", largo_laser, ": el brazo mide ", alto_brazo, " mm (máx. ", plataforma_max,
        "); use un láser más corto o equilibre con el centro de masa más al medio"));
// V-04 (012): el brazo del motor, con la aguja de índice, también entra
assert(alto_brazo_motor <= plataforma_max,
    str("holgura_aguja=", holgura_aguja, ": el brazo del motor mide ", alto_brazo_motor, " mm con la aguja (máx. ",
        plataforma_max, ")"));
// V-05: entre el carro y el eje conducido entran el tope tensor y el alojamiento del 608
assert(r_tope_int >= rod608_d_ext/2 + pared_alojamiento_608 + 2,
    str("largo_correa=", largo_correa, ": distancia entre centros ", distancia_centros,
        " mm; el tope tensor no entra entre el carro y el rodamiento (mín. ",
        rod608_d_ext/2 + pared_alojamiento_608 + 2 + recorrido_tensor + separacion_tope + largo_tope - carro_x_min,
        " mm); use una correa más larga"));
// V-06: la polea 20T no toca la polea conducida
assert(distancia_centros >= (d_exterior_conducida + polea20_d_brida)/2 + 3,
    str("largo_correa=", largo_correa, ": distancia entre centros ", distancia_centros, " mm < ",
        (d_exterior_conducida + polea20_d_brida)/2 + 3, " mm; las poleas se tocan, use una correa más larga"));
// V-27…V-29: barra de distribución (010, data-model §4)
comprobar_rango("pines_barra", pines_barra, 6, 10);
comprobar_rango("barra_largo", barra_largo, 20, 36);
comprobar_rango("barra_ancho", barra_ancho, 7, 10);
// V-27: un pin por destino en cada tira, más uno de reserva
assert(pines_barra >= max(destinos_5v, destinos_gnd) + 1,
    str("pines_barra=", pines_barra, ": la barra necesita al menos ", max(destinos_5v, destinos_gnd) + 1,
        " pines por tira (", max(destinos_5v, destinos_gnd), " destinos + reserva)"));
// V-28: la placa tiene lugar para los pines, la entrada y las esquinas libres sobre los apoyos (research R2)
assert(barra_largo >= (pines_barra + 4)*paso_pines - 0.5,
    str("barra_largo=", barra_largo, ": la placa no tiene lugar para ", pines_barra,
        " pines, la entrada y las esquinas libres (mín. ", (pines_barra + 4)*paso_pines - 0.5, " mm)"));
assert(barra_ancho >= 3*paso_pines - 0.5,
    str("barra_ancho=", barra_ancho, ": la placa no tiene lugar para las dos tiras separadas (mín. ",
        3*paso_pines - 0.5, " mm)"));
// V-29: la barra entra al lado del regulador, dentro de la columna de los ULN2003
assert(x_barra0 + ancho_soporte_barra <= x_col_a1,
    str("barra_ancho=", barra_ancho, ": la barra no entra al lado del regulador (máx. ",
        x_col_a1 - x_barra0 - 2*holgura_encastre - 2*pared_soporte, " mm)"));
// V-08: zonas de la plataforma sin solaparse
assert(len(choques_componentes) == 0,
    str(len(choques_componentes) > 0 ? choques_componentes[0] : "", "_ancho: componentes solapados en la plataforma: ",
        choques_componentes, "; reduzca las medidas del componente"));
assert(espesor_soporte_interruptor <= pared_max_interruptor && alto_interruptor + d_interruptor/2 + 2 <= alto_interior_tapa,
    str("altura_placas=", altura_placas, ": el interruptor no entra en el soporte o bajo la tapa"));
assert((x_col_b1 - x_col_a0) >= 40 && alto_sobrante_cables >= 25, "uln2003_ancho: el hueco del cable sobrante es menor que 40 × 25 mm");
assert(len(choques_tapa) == 0, str("altura_placas=", altura_placas, ": la tapa se solapa con ", choques_tapa));
assert(len(choques_conducto) == 0, str("espesor_plataforma=", espesor_plataforma, ": el conducto se solapa con ", choques_conducto));
// V-07 (planta): nada de la plataforma entra en el barrido del láser
assert(len(choques_barrido) == 0,
    str("holgura_barrido=", holgura_barrido, ": el láser toca ", choques_barrido,
        " en algún ángulo entre ", angulo_altura_min, "° y ", angulo_altura_max, "°; aumente holgura_barrido o revise el centro de masa"));
// V-10: el eje del motor entra en el cubo de la polea 20T
assert(eje_en_cubo20 >= 5,
    str("espesor_plataforma=", espesor_plataforma, ": el eje del motor entra solo ", eje_en_cubo20,
        " mm en el cubo de la polea 20T (mín. 5)"));
// Pernos del eje de altura: se pueden colocar y agarran lo suficiente
assert(alto_arandela_cable >= alto_arandela_contacto && alto_arandela_cable <= alto_arandela_contacto + 5,
    str("diametro_laser=", diametro_laser, ": la arandela de contacto del lado del cable mide ", alto_arandela_cable,
        " mm (entre ", alto_arandela_contacto, " y ", alto_arandela_contacto + 5, ")"));
assert(prof_cabeza_polea_alt >= m8_cabeza_alto/2,
    str("margen_punta_perno=", margen_punta_perno, ": el hexágono de la polea toma solo ", prof_cabeza_polea_alt,
        " mm de la cabeza del perno M8 × ", largo_perno_alt_motor, " (mín. ", m8_cabeza_alto/2, ")"));
assert(rosca_tuerca_munon >= 0.75*rod608_d_int,
    str("margen_punta_perno=", margen_punta_perno, ": el perno del lado motor agarra solo ", rosca_tuerca_munon,
        " mm de la tuerca del muñón (mín. ", 0.75*rod608_d_int, ")"));
// V-11: holguras, brazo y espesores mínimos
assert(min([holgura_encastre, holgura_tornillo_m3, holgura_tuerca, holgura_perno_m8, holgura_barrido]) > 0,
    "holgura_encastre: todas las holguras deben ser > 0");
assert(espesor_brazo >= rod608_ancho + labio_608_min,
    str("espesor_brazo=", espesor_brazo, ": no entran el 608 (", rod608_ancho, ") y su labio (", labio_608_min,
        "); mínimo ", rod608_ancho + labio_608_min));
assert(len(espesores_bajos) == 0,
    str(len(espesores_bajos) > 0 ? espesores_bajos[0] : "", " (mínimo ", espesor_min_pared,
        " mm, FR-021); todas: ", espesores_bajos));
assert(semiancho_interior_horquilla - (radio_exterior_cuna + sobre_anillo_colim) >= holgura_anillo_brazo,
    str("pared_tubo_cuna=", pared_tubo_cuna, ": los anillos de colimación quedan a ",
        semiancho_interior_horquilla - (radio_exterior_cuna + sobre_anillo_colim), " mm de los brazos (mín. ", holgura_anillo_brazo, ")"));
assert(pared_tubo_cuna + sobre_anillo_colim + 2*holgura_colimacion >= largo_prisionero,
    str("holgura_colimacion=", holgura_colimacion, ": el prisionero de ", largo_prisionero,
        " mm sobresale del anillo con el láser centrado"));
assert(d_contacto_aro < rod608_d_aro_int, "d_contacto_aro: los anillos de contacto tocarían más que el aro interior del 608");
assert(alto_brida_sup - espesor_brida - profundidad_diente_gt2 >= 0,
    "alto_brida_sup: no entra el chaflán a 45° de la pestaña superior de las poleas");
// V-12: corrección de colimación
assert(atan(2*holgura_colimacion/(largo_tubo_cuna - alto_anillo_colim)) >= 1,
    str("holgura_colimacion=", holgura_colimacion, ": la corrección del haz es de ",
        atan(2*holgura_colimacion/(largo_tubo_cuna - alto_anillo_colim)), "° (mín. 1°)"));
// V-13: centro de masa de la parte giratoria
assert(norm([x_centro_masa_plataforma, y_centro_masa_plataforma]) <= 20,
    str("powerbank_largo=", powerbank_largo, ": el centro de masa está a ",
        norm([x_centro_masa_plataforma, y_centro_masa_plataforma]), " mm del eje (máx. 20)"));
if (norm([x_centro_masa_plataforma, y_centro_masa_plataforma]) > 5 && !con_contrapeso)
    echo(str("AVISO: el centro de masa está a ", norm([x_centro_masa_plataforma, y_centro_masa_plataforma]),
             " mm del eje; active con_contrapeso"));
// V-14: separación de los 608 de azimut
assert(separacion_608_azimut + 2*rod608_ancho >= 20,
    str("separacion_608_azimut=", separacion_608_azimut, ": las caras exteriores de los 608 quedan a ",
        separacion_608_azimut + 2*rod608_ancho, " mm (mín. 20)"));
// La base no toca la polea 20T del motor de azimut
assert(diametro_apoyo_tripode/2 <= distancia_centros - polea20_d_brida/2 - 2 || z_cuerpo_base_sup <= z_polea20_az_inf - 3,
    str("diametro_apoyo_tripode=", diametro_apoyo_tripode, ": el cuerpo de la base toca la polea 20T de azimut"));
assert(z_cuerpo_base_sup > z_camara_sup,
    str("diametro_apoyo_tripode=", diametro_apoyo_tripode, ": el cono de la base baja hasta la cámara; reduzca el diámetro"));
// Presupuesto de error
assert(error_peor_caso < 2, str("error_peor_caso=", error_peor_caso, "°: supera el límite de 2°"));
if (error_rss > 1) echo(str("AVISO: error_rss=", error_rss, "° supera el objetivo de 1°"));
if (fs_par_10 < 3) echo(str("AVISO: con 10 mm de desbalance el factor de seguridad del par es ", fs_par_10, " (< 3); equilibre bien el láser"));

// V-15…V-21: láser sin batería (006, data-model Entidad 4)
comprobar_rango("diametro_hueco_bateria", diametro_hueco_bateria, 16, 22);
comprobar_rango("profundidad_hueco_bateria", profundidad_hueco_bateria, 34, 70);
comprobar_rango("diametro_zona_tapa", diametro_zona_tapa, 20, 40);
comprobar_rango("largo_zona_tapa", largo_zona_tapa, 8, 20);
comprobar_rango("largo_tapa_original", largo_tapa_original, 5, 40);
comprobar_rango("masa_bateria_g", masa_bateria_g, 15, 60);
comprobar_rango("masa_tapa_original_g", masa_tapa_original_g, 5, 40);
comprobar_rango("tuercas_lastre_tapa", tuercas_lastre_tapa, 0, 3);
comprobar_rango("distancia_trasera_centro_masa_nueva", distancia_trasera_centro_masa_nueva, 0, 200);
comprobar_rango("regulador_largo", regulador_largo, 15, 25);
comprobar_rango("regulador_ancho", regulador_ancho, 10, 18);
assert(tuercas_lastre_tapa == floor(tuercas_lastre_tapa),
    str("tuercas_lastre_tapa=", tuercas_lastre_tapa, ": debe ser un número entero de tuercas"));
assert(diametro_hueco_bateria + 2*pared_min_tubo_laser <= diametro_zona_tapa,
    str("diametro_hueco_bateria=", diametro_hueco_bateria, ": el hueco de la batería no entra en el tubo de ",
        diametro_zona_tapa, " mm (pared mín. ", pared_min_tubo_laser, " mm)"));
assert(d_pila_falsa/2 - descentrado_hilo_pila - d_paso_hilo/2 >= espesor_min_pared
       && descentrado_hilo_pila - d_paso_hilo/2 >= r_esquina_tuerca_contacto + 0.4,
    str("diametro_hueco_bateria=", diametro_hueco_bateria, ": la pila falsa es muy fina para el paso del hilo"));
// V-30 (013): el ojal del contacto positivo, con su lengüeta hasta el agujero del hilo, entra en la cara de la pila
assert(descentrado_hilo_pila + ancho_lengueta_ojal/2 <= d_pila_falsa/2 - 0.5 && d_ext_ojal/2 <= d_pila_falsa/2 - 0.5,
    str("diametro_hueco_bateria=", diametro_hueco_bateria, ": el ojal del contacto positivo no entra en la cara de la pila falsa"));
assert(tuercas_lastre_tapa == 0 || r_funda_int - r_esquina_lastre >= 1,
    str("tuercas_lastre_tapa=", tuercas_lastre_tapa, ": las tuercas M10 de lastre no dejan escalón para el borde del tubo de ",
        diametro_zona_tapa, " mm"));
assert(plastico_prisionero + holgura("deslizante") + m3_tuerca_alto + espesor_ojal + 1 <= largo_prisionero_tapa,
    str("espesor_resalte_prisionero=", espesor_resalte_prisionero, ": el prisionero M3 × ", largo_prisionero_tapa,
        " no alcanza para el ojal y la contratuerca"));
assert(hueco_equilibrado >= ancho_grapa + 2*recorrido_equilibrado,
    str("distancia_trasera_centro_masa_nueva=", distancia_trasera_centro_masa_nueva, ": la tapa trasera queda a ",
        hueco_equilibrado, " mm de la cuna (mín. ", ancho_grapa + 2*recorrido_equilibrado,
        "): no hay lugar para la grapa y el equilibrado"));
assert(caida_cable_v < 0.1,
    str("largo_cable_laser=", largo_cable_laser, ": el cable hace caer ", caida_cable_v, " V (máx. 0,1 V)"));
assert(regulador_largo >= regulador_ancho && regulador_ancho + 2*holgura_encastre + 2*pared_soporte <= ancho_col_a,
    str("regulador_ancho=", regulador_ancho, ": el regulador no entra en la columna de los ULN2003 (máx. ",
        ancho_col_a - 2*holgura_encastre - 2*pared_soporte, " mm) o es más ancho que largo"));
if (alto_brazo > alto_brazo_max_flexion)
    echo(str("AVISO: alto_brazo=", alto_brazo, " supera 131 mm: repetir el cálculo de flexión (research 006, R5)"));

// V-22…V-25: conectores y cables (009, data-model §4)
comprobar_rango("largo_dupont", largo_dupont, 10, 20);
comprobar_rango("alto_tira_pines", alto_tira_pines, 2, 3.5);
comprobar_rango("diametro_cable_dupont", diametro_cable_dupont, 1, 2);
comprobar_rango("radio_curva_cable", radio_curva_cable, 3, 10);
comprobar_rango("alto_enchufe_motor", alto_enchufe_motor, 9, 18);
comprobar_rango("pines_por_lado_esp32", pines_por_lado_esp32, 15, 20);
comprobar_rango("ancho_enchufe_usb", ancho_enchufe_usb, 8, 14);
comprobar_rango("alto_enchufe_usb", alto_enchufe_usb, 5, 10);
comprobar_rango("largo_cable_motor", largo_cable_motor, 150, 400);
// V-22: los conectores de arriba de las placas y el ESP32 quedan bajo el techo de la tapa
assert(max(alto_conectores_arriba, alto_enchufes_motor, alto_esp32_total) + holgura_techo_tapa <= alto_interior_tapa,
    str("largo_dupont=", largo_dupont, ": un conector toca el techo de la tapa"));
// V-23: los Dupont del ESP32 (hacia abajo, con la curva del cable) quedan sobre la plataforma
assert(elevacion_esp32 - alto_dupont_conectado >= holgura_conector,
    str("largo_dupont=", largo_dupont, ": los Dupont del ESP32 tocan la plataforma"));
// V-24: entre las curvas de los Dupont de las dos filas del ESP32 queda lugar para sus apoyos
assert(ancho_apoyo_esp32 >= 3,
    str("separacion_filas_esp32=", separacion_filas_esp32, ": entre las curvas de los Dupont del ESP32 quedan ",
        ancho_apoyo_esp32, " mm para los apoyos (mín. 3)"));
assert(2*ancho_franja_esp32 + holgura_conector <= esp32_ancho,
    str("radio_curva_cable=", radio_curva_cable, ": las curvas de los cables de las dos filas del ESP32 se cruzan"));
// V-25: el enchufe USB pasa entre los postes del soporte y la abertura deja material en el techo
assert(ancho_abertura_usb/2 <= esp32_ancho/2 - (pierna_soporte - pared_soporte - holgura_encastre) - holgura_conector,
    str("ancho_enchufe_usb=", ancho_enchufe_usb, ": el enchufe USB toca los postes del soporte del ESP32"));
assert(z_usb_esp32 + alto_abertura_usb/2 <= alto_tapa - 1,
    str("alto_enchufe_usb=", alto_enchufe_usb, ": la abertura USB llega al techo de la tapa"));

// --- SALIDA DE DERIVADOS (echo) ---
echo(str("FIRMWARE pasos_por_grado=", pasos_por_grado, ", grados_por_paso=", grados_por_paso,
         ", pasos_por_vuelta_eje=", pasos_por_vuelta_eje));
echo(str("DISEÑO distancia_centros=", distancia_centros, ", altura_eje=", altura_eje, ", alto_brazo=", alto_brazo,
         ", plano_correa_altura=", plano_correa_altura, ", largo_cubo_polea_altitud=", largo_cubo_polea_altitud,
         ", plataforma=", largo_plataforma, "x", ancho_plataforma,
         ", x_centro_masa=", x_centro_masa_plataforma, ", y_centro_masa=", y_centro_masa_plataforma,
         ", masa_estimada_g=", masa_estimada_g));
echo(str("LASER masa_laser_mod_g=", masa_laser_mod_g, ", l_trasero=", l_trasero, ", l_delantero=", l_delantero,
         ", largo_tapa_fuera=", largo_tapa_fuera, ", largo_pila_falsa=", largo_pila_falsa,
         ", hueco_equilibrado=", hueco_equilibrado, ", caida_cable_v=", caida_cable_v,
         ", r_tapa_trasera=", r_tapa_trasera, ", alto_col_a=", alto_col_a));
echo(str("COTAS z_tope_base=", z_tope_base, ", z_plataforma_sup=", z_plataforma_sup, ", z_eje_altura=", z_eje_altura,
         ", semiancho_horquilla=", semiancho_interior_horquilla, ", alto_tapa=", alto_tapa,
         ", elevacion_esp32=", elevacion_esp32));
echo(str("PERNOS azimut=M8x", largo_perno_azimut, ", altura_motor=M8x", largo_perno_alt_motor,
         ", altura_cable=M8x", largo_perno_alt_cable));
echo(str("PARES disponible=", par_disponible_mNm, ", desbalance_10=", par_desbalance_10_mNm, ", fs_10=", fs_par_10,
         ", desbalance_20=", par_desbalance_20_mNm, ", fs_20=", fs_par_20));
echo(str("PRESUPUESTO rss=", error_rss, ", peor_caso=", error_peor_caso));

// --- MÓDULOS UTILITARIOS COMPARTIDOS ---
// Dentado GT2 de una polea impresa (cilindro con los huecos de los dientes), de z = 0 a alto.
module dentado_gt2(dientes, alto) {
    r_ext = dientes*paso_gt2/PI/2 - pld_gt2;
    r_hueco = radio_hueco_gt2 + ajuste_diente_gt2;
    difference() {
        cylinder(r = r_ext, h = alto, $fn = dientes*4);
        for (i = [0:dientes-1])
            rotate([0, 0, i*360/dientes])
                translate([r_ext - profundidad_diente_gt2 + r_hueco, 0, -1])
                    cylinder(r = r_hueco, h = alto + 2, $fn = 16);
    }
}
// Pestañas de una polea impresa con dentado de z = 0 a alto_dentado: inferior plana y superior
// con chaflán de 45° por debajo (imprimible sin soportes).
module pestanas_polea(d_ext, alto_dentado) {
    translate([0, 0, -espesor_brida]) cylinder(d = d_ext + 2*espesor_brida, h = espesor_brida + eps);
    translate([0, 0, alto_dentado - eps])
        cylinder(d1 = d_ext - 2*profundidad_diente_gt2, d2 = d_ext + 2*espesor_brida, h = espesor_brida + profundidad_diente_gt2 + eps);
    translate([0, 0, alto_dentado + espesor_brida + profundidad_diente_gt2 - eps])
        cylinder(d = d_ext + 2*espesor_brida, h = alto_brida_sup - espesor_brida - profundidad_diente_gt2 + 2*eps);
}
// Agujero horizontal en forma de gota (eje a lo largo de X), con la punta hacia +Z.
module agujero_gota(d, largo) {
    // Tras rotate([0, 90, 0]) el −X local del perfil queda hacia +Z: la punta se dibuja hacia −X.
    rotate([0, 90, 0])
        linear_extrude(height = largo, center = true)
            union() {
                circle(d = d);
                rotate([0, 0, 135]) square(d/2);
            }
}
// Alojamiento hexagonal de tuerca o cabeza (ec entre caras), eje Z, de z = 0 a alto.
module alojamiento_hex(ec, alto) {
    cylinder(d = (ec + holgura_tuerca)/cos(30), h = alto, $fn = 6);
}
// Ranura alargada en X (agujero de diámetro d desplazable ±largo/2), eje Z.
module ranura(d, largo, alto) {
    hull() for (s = [-1, 1]) translate([s*largo/2, 0, 0]) cylinder(d = d, h = alto);
}
// Rectángulo de esquinas redondeadas (extruido), desde [x0, y0] hasta [x1, y1].
module placa_redondeada(x0, y0, x1, y1, r, alto) {
    hull() for (x = [x0 + r, x1 - r], y = [y0 + r, y1 - r]) translate([x, y, 0]) cylinder(r = r, h = alto);
}
