nativosistemas/piezas3D/src/soporte_pared_taladro.scad

// ==========================================
// Proyecto: piezas3D
// Componente: Soporte de pared para taladro
// Descripción: soporte paramétrico de pared para colgar un taladro inalámbrico por el portabrocas
// ==========================================
//
// Ejes: X = ancho (paralelo a la pared), Y = profundidad (la pared está en Y = 0),
// Z = altura (la cara inferior de la bandeja está en Z = 0). La pieza se modela en la
// orientación de impresión: bandeja sobre la cama, placa trasera y cartelas en vertical.
// Especificación: specs/001-soporte-pared-taladro/

// --- PARÁMETROS Y CONSTANTES ---

/* [Dimensiones principales] */
// Ancho total de la pieza a lo largo de la pared (mm)
ancho = 80; // [50:1:150]
// Vuelo de la bandeja medido desde la pared (mm)
profundidad = 100; // [60:1:160]
// Diámetro nominal de los tornillos de fijación a pared (mm)
diametro_tornillo = 5; // [3:0.5:8]

/* [Taladro] */
// Ancho de la ranura por la que pasa el portabrocas (mm)
ancho_ranura = 46; // [30:1:60]
// Diámetro del cuerpo o caja de engranajes del taladro; solo se usa para validar holguras (mm)
diametro_cuerpo_taladro = 60; // [40:1:90]

/* [Estructura] */
// Espesor de la bandeja y de la placa trasera (mm)
espesor = 6; // [4:0.5:10]
// Altura total de la placa trasera (mm)
altura_placa = 70; // [50:1:120]
// Espesor de cada cartela lateral de refuerzo (mm)
espesor_cartela = 5; // [3:0.5:10]

/* [Detalles] */
// Holgura de paso añadida al diámetro del tornillo (mm)
holgura_tornillo = 0.4; // [0.2:0.05:1.0]
// Altura del labio de retención frontal; 0 lo desactiva (mm)
altura_labio = 3; // [0:0.5:4.5]
// Chaflán a 45° del borde superior de la ranura; 0 lo desactiva (mm)
chaflan_ranura = 1.5; // [0:0.5:3]
// Radio de las esquinas frontales y de la boca de la ranura; 0 las deja vivas (mm)
radio_esquinas = 4; // [0:0.5:10]
// Radio del filete interior entre placa y bandeja; 0 lo desactiva (mm)
radio_filete = 3; // [0:0.5:6]

/* [Calidad] */
// Resolución de las superficies curvas (segmentos por circunferencia)
$fn = 64; // [24:8:128]

/* [Hidden] */
// Constantes de diseño (data-model.md, Entidad 2)
longitud_labio = 6;                          // longitud en Y del labio de retención
holgura_cuerpo_min = longitud_labio + 2;     // holgura mínima cuerpo-placa y cuerpo-labio
margen_cuerpo_carril = 8;                    // apoyo mínimo del cuerpo sobre los carriles (total)
holgura_cuerpo_cartela = 2;                  // holgura mínima entre el cuerpo y las cartelas
altura_cartela_min_util = 10;                // altura útil mínima de cartela bajo los tornillos
espesor_min_pared = 1.2;                     // 3 líneas de extrusión de 0,4 mm (FR-012)
espesor_min_bajo_avellanado = 1.5;           // placa mínima bajo la cabeza del tornillo
rebaje_cabeza = 0.3;                         // la cabeza queda por debajo de la superficie
eps = 0.01;                                  // solape para evitar caras coplanarias

// Valores derivados
diametro_orificio = diametro_tornillo + holgura_tornillo;
diametro_cabeza = 2 * diametro_tornillo;
profundidad_avellanado = (diametro_cabeza - diametro_orificio) / 2 + rebaje_cabeza;
ancho_carril = (ancho - ancho_ranura) / 2;
radio_ranura = ancho_ranura / 2;
centro_ranura_y = espesor + (profundidad - espesor) / 2;
fondo_ranura_y = centro_ranura_y - radio_ranura;
tornillo_z = altura_placa - diametro_cabeza;
tornillo_x = [diametro_cabeza, ancho - diametro_cabeza];
altura_cartela = tornillo_z - diametro_cabeza;
fin_cartela_y = profundidad - longitud_labio - 2;
// Los dos redondeos de la punta de cada carril (exterior y boca) no pueden solaparse
radio_esquinas_util = min(radio_esquinas, ancho_carril / 2 - eps);

// Parámetros públicos: [nombre, valor, [mínimo, máximo], unidad] (regla V-01)
parametros_publicos = [
    ["ancho", ancho, [50, 150], " mm"],
    ["profundidad", profundidad, [60, 160], " mm"],
    ["diametro_tornillo", diametro_tornillo, [3, 8], " mm"],
    ["ancho_ranura", ancho_ranura, [30, 60], " mm"],
    ["diametro_cuerpo_taladro", diametro_cuerpo_taladro, [40, 90], " mm"],
    ["espesor", espesor, [4, 10], " mm"],
    ["altura_placa", altura_placa, [50, 120], " mm"],
    ["espesor_cartela", espesor_cartela, [3, 10], " mm"],
    ["holgura_tornillo", holgura_tornillo, [0.2, 1.0], " mm"],
    ["altura_labio", altura_labio, [0, 4.5], " mm"],
    ["chaflan_ranura", chaflan_ranura, [0, 3], " mm"],
    ["radio_esquinas", radio_esquinas, [0, 10], " mm"],
    ["radio_filete", radio_filete, [0, 6], " mm"],
    ["$fn", $fn, [24, 128], " segmentos"]
];

function en_rango(valor, rango) = is_num(valor) && valor >= rango[0] && valor <= rango[1];

// Suma de los elementos de un vector
function suma(v, i = 0) = i >= len(v) ? 0 : v[i] + suma(v, i + 1);

// Área con signo de un perfil 2D (positiva si los vértices van en sentido antihorario)
function area_perfil(p) =
    0.5 * suma([for (i = [0:len(p) - 1])
        p[i][0] * p[(i + 1) % len(p)][1] - p[(i + 1) % len(p)][0] * p[i][1]]);

// --- VALIDACIÓN DE PARÁMETROS ---
// Reglas V-01 a V-10 de data-model.md, en orden. Cada mensaje empieza por el parámetro
// principal implicado (contracts/interfaz_generador.md §2.2).

// V-01: cada parámetro es numérico y está dentro de su rango
for (p = parametros_publicos)
    assert(en_rango(p[1], p[2]),
        str(p[0], "=", p[1], ": fuera de rango [", p[2][0], ", ", p[2][1], "]", p[3]));

// V-02: material suficiente a cada lado de la ranura
assert(ancho_carril >= 2 * espesor,
    str("ancho_ranura=", ancho_ranura, ": deja carriles de ", ancho_carril,
        " mm; con espesor=", espesor, " se necesitan al menos ", 2 * espesor,
        " mm (reduzca ancho_ranura o aumente ancho)"));
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
