nativosistemas/piezas3D/(list of files, cad)

Other CAD files:
exports/soporte_pared_taladro.stl
