nativosistemas/piezas3D/(commit log)

2026-10-04 Inicializar proyecto piezas3D con GitHub Spec Kit
    - Instalar Spec Kit para Claude Code (.specify/ y skills /speckit-*)
    - Constitución v1.0.0: diseño paramétrico en OpenSCAD, pipeline de
    cuatro fases, simulación en FreeCAD, manufactura aditiva (.stl) y
    documentación de producción obligatoria
    - Perfil del agente con plantillas de salida en .github/spec_kit_profile.md
    - Estructura de carpetas: src/, simulation/, exports/, docs/
    - CLAUDE.md y .gitignore
2026-10-04 docs: enmendar constitución a v1.0.1
    - Estructura del repositorio: se añade .tools/ (herramientas locales instaladas
    sin privilegios, excluido de git) a las excepciones permitidas.
    - Principio V: la plantilla de la guía es la sección 4.B de
    .github/spec_kit_profile.md y cada diseño usa docs/<nombre_pieza>_guia.md.
    Aclaraciones de redacción (PARCHE) derivadas de los hallazgos K1 y A2 de
    /speckit-analyze; no cambian ningún principio.
2026-10-04 feat: soporte de pared paramétrico para taladro
    Generador OpenSCAD de un soporte de pared para colgar un taladro inalámbrico
    por el portabrocas, con ancho, profundidad, diámetro de tornillo y otros 11
    parámetros ajustables (Customizer y -D), validados con assert (V-01 a V-10).
    Pipeline completo de la constitución:
    - Diseño: src/soporte_pared_taladro.scad. Pieza en L con bandeja, ranura en U
    con chaflán, labios de retención, cartelas y avellanados. Se imprime sin
    soportes (0 voladizos > 45°) y solo usa primitivas importables en FreeCAD.
    - Simulación: script FEM (FreeCAD 1.1.4 + Gmsh + CalculiX) y guía. Con 25 N,
    σ máx. 0,49 MPa y flecha 0,04 mm (pésimo: 2,18 MPa y 0,21 mm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
    [soporte_pared_taladro.FCStd, soporte_pared_taladro.scad, soporte_pared_taladro.stl]
2026-10-05 docs: constitución v1.1.0 y herramientas del sistema
    Constitución 1.0.1 → 1.1.0 (MENOR), con buenas prácticas adaptadas del skill
    comunitario andreahaku/openscad_claude_skill:
    - Principio I: orden fijo del archivo, eps en los cortes, validación con
    assert() y cotas relativas a bordes.
    - Principio IV: perfil de impresora único como fuente de holguras y límites.
    - Puerta 1: validación estricta, chequeo de la caja envolvente y revisión de
    capturas PNG.
    - Perfil de Spec Kit actualizado y skill nueva disenio-multipieza.
    Herramientas: los lanzadores de .tools/bin/ pasan a usar OpenSCAD 2021.01 de
    apt y FreeCAD 1.1.1 en snap, en lugar de las AppImage extraídas (−4 GB).
    FreeCAD, cc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
2026-10-05 feat: puntero láser estelar motorizado
    Montura altitud-azimut de 10 piezas impresas que apunta un puntero láser verde
    a cualquier estrella. Se enrosca al 3/8"-16 de un trípode; un ESP32 mueve dos
    28BYJ-48 con correas GT2 (reducción 1:4) y enciende el láser con un relé.
    Error de apuntado estimado 0,5° (1,35° en el peor caso) frente a 2°.
    - Diseño: medidas compartidas en src/puntero_laser_parametros.scad, una pieza
    por archivo y src/puntero_laser_ensamblaje.scad con assert de choque a
    −10°, 0°, 45°, 90° y 95°. Validación estricta sin avisos.
    - Simulación: no aplica (σ ≤ 1 MPa frente a 20 MPa del PETG entre capas,
    factor de seguridad > 20); justificado en research.m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
    [puntero_laser_adaptador_tripode.scad, puntero_laser_adaptador_tripode.stl, puntero_laser_brazo_horquilla.scad, puntero_laser_brazo_horquilla_cable.stl, puntero_laser_brazo_horquilla_motor.stl, puntero_laser_carro_motor.scad, puntero_laser_carro_motor.stl, puntero_laser_cuna_laser.scad]
2026-10-06 feat: automatización del pipeline y web de armado (etapas 1 y 2)
    - Inventario de las instrucciones del agente (specs/003-instrucciones-y-web/inventario.md).
    - scripts/verificar_pieza.sh: validación estricta, caja envolvente, apoyo en Z = 0, cama y capturas.
    - Hook PostToolUse: valida cada src/*.scad al editarlo.
    - src/perfil_impresora.scad: perfil real (sin medir) como fuente de holguras y cama.
    - docs/puntero_laser_bom.csv y docs/tipo_cambio.csv: materiales y precios con fuente y fecha.
    - scripts/generar_web.py: web de armado en specs/<NNN>/web/ y bloque de materiales de la guía
    generado desde el CSV; --comprobar para la puerta de calidad.
    - Ensamblaje con catálogo único de elementos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
    [perfil_impresora.scad, puntero_laser_bom.csv, puntero_laser_ensamblaje.scad, tipo_cambio.csv]
2026-10-06 docs: dividir el perfil en una skill por fase (etapa 3)
    - pieza-openscad (fases 1 y 3): supuestos, plantilla .scad, verificación, exportación,
    modificar STL de terceros, errores frecuentes y calibración.
    - simulacion-freecad (fase 2): cuándo simular o justificar, criterios, exportación CSG,
    script y documentación, a partir de la simulación del soporte del taladro.
    - guia-produccion (fase 4): plantilla de la guía con títulos fijos y formato del CSV de materiales.
    - web-armado (fase 5): reglas de precios verificados, vistas explotadas y puerta 5.
    - disenio-multipieza: recortada a cuándo dividir, uniones con holgura("…"), organización de
    archivos y tabla de pasos de armado.
    -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
2026-10-06 docs: enmendar constitución a v2.0.0 (pipeline de cinco fases, web de armado y organización de las instrucciones)
    - Principio II: cinco fases; la fase 5 es la web de armado.
    - Principio V: lista de materiales en docs/<diseño>_bom.csv, web generada con precios verificados
    en ARS y USD (nunca estimados) y vistas explotadas por paso en diseños de varias piezas.
    - Principio III: la simulación debe poder repetirse y fijar su rango validado.
    - Principio IV: límites de impresión tomados de src/perfil_impresora.scad.
    - Estructura: scripts/, datos en docs/, specs/<NNN>/web/ y convención obligatoria de varias piezas.
    - Puerta de calidad 5 y criterio "cada regla en un solo lugar" en Gobernanz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
2026-10-06 docs: CLAUDE.md como mapa del proyecto y eliminar el perfil (etapa 5)
    - CLAUDE.md: tabla de fases → skills, datos del proyecto, scripts y hook, flujo de Spec Kit y
    avisos del entorno (qué se ejecuta fuera del sandbox).
    - Se elimina .github/spec_kit_profile.md: su contenido está en las skills, scripts/ y la
    constitución. Las specs 001 y 002 lo siguen citando como historial.
2026-10-08 fix: armado del eje de altura del puntero láser y vistas explotadas
    - El perno M8 × 55 del lado motor no se podía meter desde dentro de la cuna
    (60 mm con la cabeza en un tubo de 34 mm). Ahora entra desde afuera por la
    polea y se enrosca en una tuerca M8 común alojada en el muñón +X; la cabeza
    queda en el hexágono de la polea y hace de chaveta. Se reimprimen la cuna y
    la polea; el resto de las piezas no cambia.
    - La cuna (60 mm con los anillos de contacto) no entraba entre los brazos ya
    atornillados (50 mm). Nuevo orden: la horquilla (brazos + cuna + polea) se
    arma suelta y después se atornilla a la plataforma. Guía, lista de
    materiales y vistas explotadas actualizadas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
    [puntero_laser_bom.csv, puntero_laser_cuna_laser.scad, puntero_laser_cuna_laser.stl, puntero_laser_ensamblaje.scad, puntero_laser_parametros.scad, puntero_laser_polea_altitud.scad, puntero_laser_polea_altitud.stl]
2026-10-08 docs: especificación del visor 3D de armado (005)
    Visor 3D paso a paso, generado desde el ensamblaje y la guía de cada diseño
    de varias piezas: página aparte junto a la web de armado, sin internet ni
    servidor, obligatorio para todo diseño con ensamblaje (requiere enmendar la
    constitución). La realidad aumentada queda para una funcionalidad posterior.
2026-10-08 feat: caja con tapa a presión para 4 pilas AA
    Caja y tapa paramétricas (cantidad de pilas y medidas), ensamblaje con
    comprobaciones del encastre y vistas explotadas, STL, guía de producción,
    lista de materiales y web de armado. Pendiente: las pruebas físicas.
    [caja_pilas_bom.csv, caja_pilas_caja.scad, caja_pilas_caja.stl, caja_pilas_ensamblaje.scad, caja_pilas_parametros.scad, caja_pilas_tapa.scad, caja_pilas_tapa.stl]
2026-10-08 feat: visor 3D de armado (005)
    Visor 3D paso a paso generado desde el ensamblaje y la guía de cada diseño de
    varias piezas: specs/<NNN>/web/armado_3d.html, un solo archivo que funciona
    sin internet ni servidor. Las piezas de cada paso se mueven desde la vista
    explotada hasta su lugar (en dos tramos si tienen origen, girando si tienen
    giro), lo ya armado se ve transparente y se puede girar, acercar, recorrer el
    movimiento y cambiar de paso.
    - src/armado_comun.scad: vistas explotadas, contexto según los subconjuntos,
    datos para el visor y despacho comunes; los ensamblajes del puntero láser
    y de la caja de pilas la usan.
    - scripts/generar_visor.py y scripts/plantilla_visor.html, con th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
    [armado_comun.scad, caja_pilas_ensamblaje.scad, puntero_laser_ensamblaje.scad]
2026-10-08 docs: enmendar constitución a v2.1.0 (visor 3D de armado obligatorio)
    - Principio V: todo diseño de varias piezas con ensamblaje debe tener un
    visor 3D de armado generado desde su ensamblaje y su guía, que funcione sin
    internet ni servidor; las vistas explotadas en PNG se mantienen.
    - Puerta 5: --comprobar cubre el visor y el visor se revisa en un navegador.
    - Estructura: specs/<NNN>/web/ incluye el visor; scripts/vendor/ guarda el
    motor 3D.
2026-10-15 feat: láser alimentado desde el power bank (006)
    Se quita la batería del láser 303 y se alimenta desde el power bank: el relé
    corta la línea de 5 V antes de un regulador reductor ajustado a 3,7 V, así el
    láser queda apagado siempre que el ESP32 no ordene encenderlo.
    - Piezas nuevas: pila falsa, tapa trasera sin rosca (prisioneros M3) y grapa
    del cable; el cable sale por la cola del láser y corre por fuera de la cuna
    hasta el muñón −X.
    - Cuna, plataforma de azimut, parámetros y ensamblaje adaptados; STL, guía,
    lista de materiales, vistas explotadas, web y visor 3D regenerados.
    - Las medidas del láser son supuestas: falta medir el ejemplar real.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
2026-10-15 feat: simulación de funcionamiento en el visor 3D (007)
    El visor 3D de armado suma la pestaña Funcionamiento para los diseños que
    declaran partes móviles: un deslizador por eje, los motores girando según su
    correa (con una marca en cada polea), el haz del láser que se enciende y un
    modo automático que recorre objetivos de demostración a la velocidad real
    (×1, ×5, ×20).
    - src/armado_comun.scad: listas opcionales (articulaciones, motores,
    emisores, objetivos, deformables, transparentes) leídas con is_undef,
    validadas con assert y entregadas con paso_armado=-1.
    - Puntero láser: azimut y altura con sus motores (relación ±4 desde
    relacion_correa), el láser como emisor, 6 ob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
2026-10-15 feat: identificación de componentes en el visor 3D (008)
    El visor 3D nombra cada pieza: la lista "Piezas de este paso" muestra
    nombres legibles con una marca de tipo (impresa o comprada), y al pasar el
    puntero o tocar una pieza en la escena se resalta y aparece una etiqueta con
    su nombre y su tipo, en los modos Armado y Funcionamiento.
    - src/armado_comun.scad: lista opcional nombres_elementos ([elemento,
    nombre, tipo]) leída con is_undef y validada con assert (cubre el
    catálogo exacto, sin repetidos, nombre no vacío, tipo impresa/comprada);
    sale con paso_armado=-1 como una línea NOMBRE por elemento, con el nombre
    al final porque echo no escapa las comillas.
    - Puntero láser y c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
2026-10-15 feat: espacio para conectores y cableado del puntero láser (009)
    La electrónica se había dimensionado sin el lugar de los conectores: con
    Dupont rectos, los del ESP32 (pines hacia abajo, elevado 15 mm) tocaban la
    plataforma y la tapa no tenía lugar para la curva de los cables.
    - Parámetros de conectores y cables (largo del Dupont, tira de pines,
    curva del cable, enchufe del motor, pines del ESP32, enchufe USB, largo
    del cable del motor). De ellos salen la elevación del ESP32 (15 → 23,9
    mm) y el alto de la tapa (27,6 → 33,5 mm; el + 5 fijo pasa a una holgura
    de techo de 2 mm). El límite del carro de altura (34,34 mm) admite
    Dupont de hasta ≈ 14,8 mm.
    - Validaciones V-2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
2026-10-15 fix: favicon vacío en las webs de armado
    Sin favicon declarado, el navegador pedía /favicon.ico de la raíz de
    nativosistemas.github.io y mostraba el icono de otro proyecto.
2026-10-17 feat: barra de distribución de alimentación del puntero láser (010)
    El esquema repartía +5 V a 5 destinos y GND a 5 placas, pero un Dupont no
    se bifurca y ni la guía, ni la lista de materiales, ni el modelo decían
    cómo hacer esa unión.
    - Barra de distribución: trozo de placa perforada de 3 × 10 agujeros con
    dos tiras de 6 pines macho (+5 V y GND), con su soporte en la plataforma
    al lado del regulador, bajo la tapa. Parámetros pines_barra, barra_largo
    y barra_ancho; validaciones V-27 a V-29.
    - Ensamblaje: elemento "barra" con sus pines y sus Dupont dentro del
    espacio reservado de los conectores (comprobaciones de choque de la 009).
    - Lista de materiales: placa perforada, t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
2026-10-17 feat: vista de cableado del visor 3D y adaptación a los componentes reales (011)
    - Vista de cableado en el visor 3D del puntero láser (spec 011).
    - Láser 303 de 20 × 152 mm: cuna de 80 mm, sin lastre M10, y perno M8 × 25
    del lado del cable que entra desde afuera hasta una tuerca en el muñón
    (arandela de contacto de 5,3 mm). La altura del eje se calcula también
    para que el motor de altura pase sobre el de azimut y la tapa.
    - ESP32 NodeMCU-32S (48 × 25,5 mm, filas a 22,86 mm): apoyos centrales en
    los extremos, entre las filas de Dupont.
    - El cable de los motores sale directo de la tapa, sin ficha en ese extremo.
    - Lista de materiales: motores con ULN2003, láser, ESP32 y power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
2026-10-17 chore: perfil de impresora para la Bambu Lab A1
    Cama de 256 × 256 × 256 mm y nota sobre la placa de PEI para PETG en las
    guías; webs de armado regeneradas.
2026-10-17 feat: marcas de orientación y escala de altura del puntero láser (012)
    - Base con «S» y «O» grabadas e índice de azimut en el borde de la plataforma.
    - Disco de la escala de altura (0° a 90° cada 15°) con el cero regulable y
    aguja de índice en el brazo del motor.
    - Posición modelada = sur (azimut 180°) en el visor; guía con orientación
    al sur, declinación (NOAA), cero de la escala y posición de partida.
2026-11-07 feat: circuito del láser en el visor 3D del puntero (013)
    - Botón «Circuito del láser» en el modo Cableado: deja a la vista el
    recorrido de la corriente (pila falsa, hilos rojo y negro, tornillo M3 del
    positivo, prisionero M3 del negativo, tuercas, ojales y tubo) y atenúa lo
    demás. También se abre con ?modo=cableado&circuito=laser.
    - Mecanismo genérico de circuitos en armado_comun.scad y generar_visor.py,
    con grupos ordenados, miembros translúcidos y encuadre inicial.
    - 9 piezas compradas nuevas modeladas en el ensamblaje del puntero.
    - Guía: prueba de continuidad del tubo y esquema del prisionero del negativo.
    - Skills disenio-multipieza y web-armado: cómo declarar y rev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
2026-11-07 chore: ignorar los archivos vacíos que deja el sandbox en la raíz
    Dotfiles de la raíz (.bashrc, .gitconfig, .mcp.json…) e .idea y .vscode
    también cuando son archivos, no carpetas.
